andreasbuerkler/audio/hw/V1_0/fpga.brd

## EAGLE design hw/V1_0/fpga.brd (2018-10-08, an earlier design)

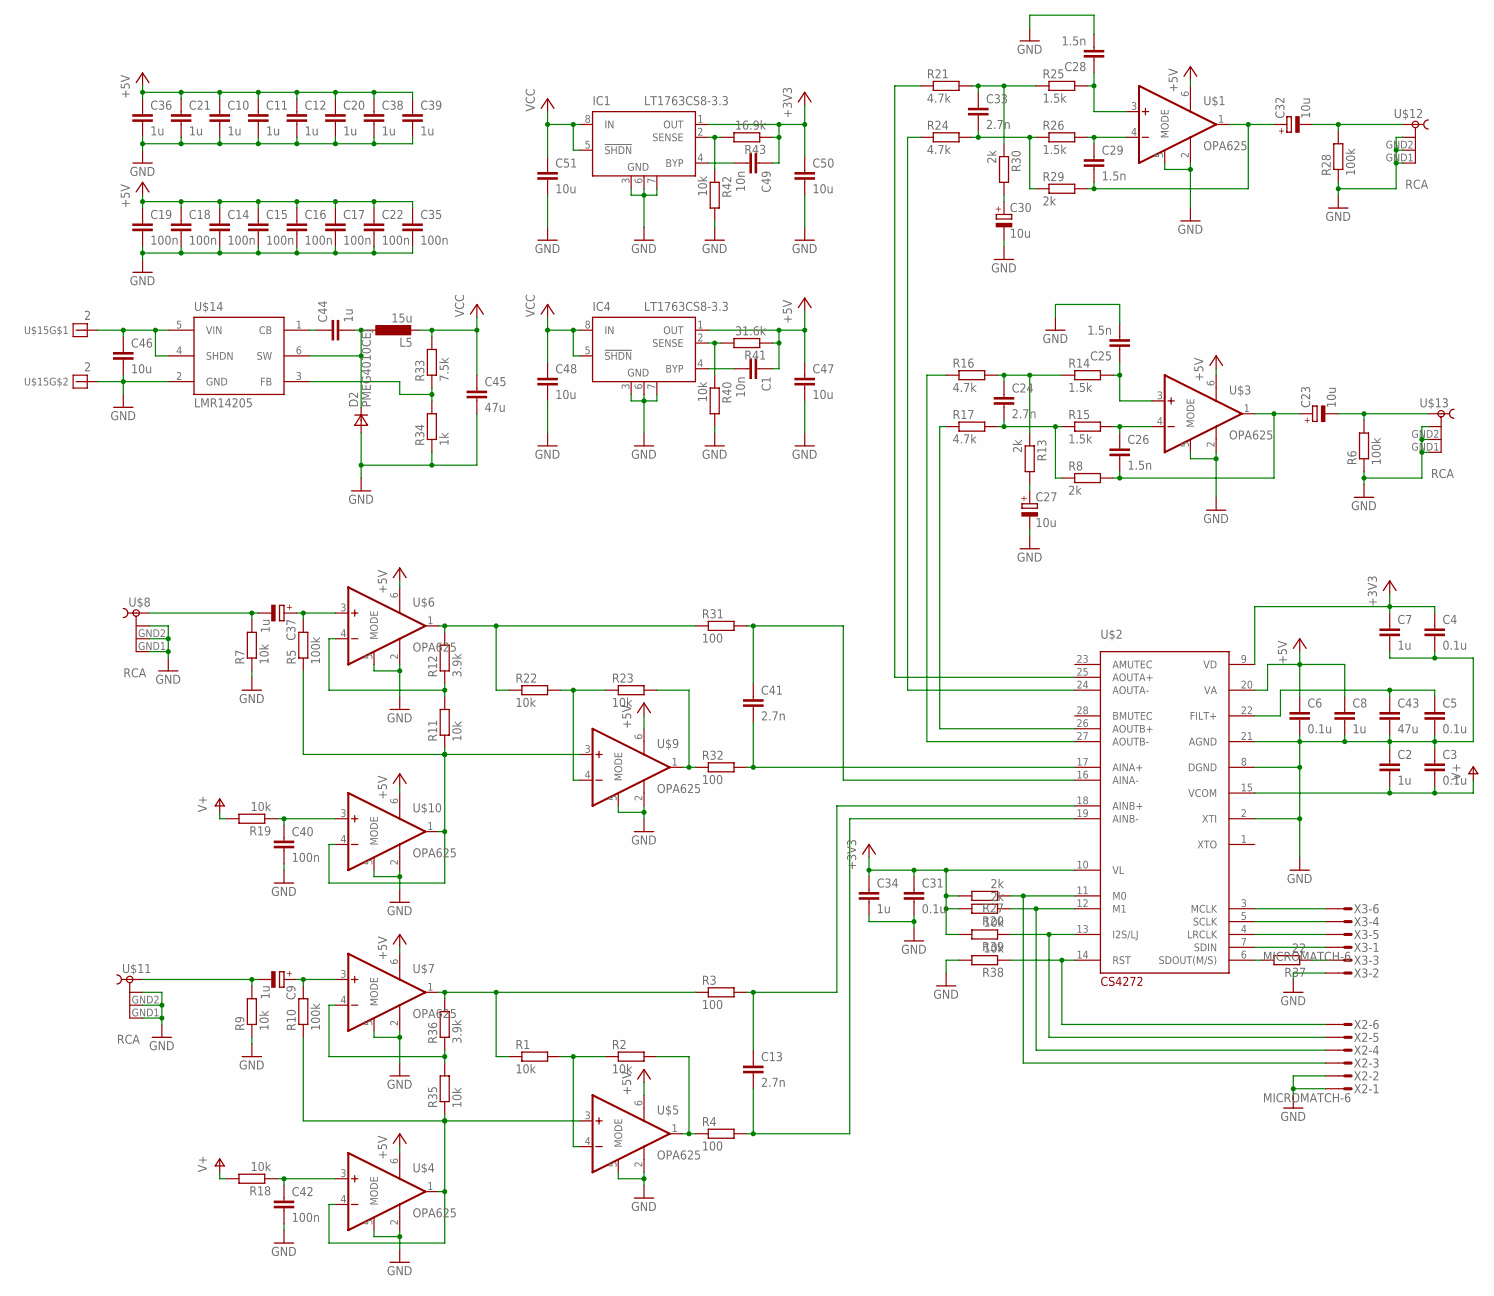
[picture p1: schematic fpga.sch]

Parts:
C1, C49: 10n; C0603K
C2, C7, C8, C10, C11, C12, C20, C21, C34, C36, C38, C39, C44: 1u; C0603K
C3, C4, C5, C6, C31: 0.1u; C0603K
C9, C37: 1u; 153CLV-0405
C13, C24, C33, C41: 2.7n; C0603K
C14, C15, C16, C17, C18, C19, C22, C35, C40, C42: 100n; C0603K
C23, C27, C30, C32: 10u; 153CLV-0405
C25, C26, C28, C29: 1.5n; C0603K
C43: 47u; C0805
C45: 47u; C1206
C46: 10u; C0805
C47, C48, C50, C51: 10u; C0603K
D2: PMEG4010CEJ; SOD323
IC1, IC4: LT1763CS8-3.3; SOIC8
L5: 15u; AAA
R1, R2, R7, R9, R11, R18, R19, R22, R23, R35, R38, R39, R40, R42: 10k; R0603
R3, R4, R31, R32: 100; R0603
R5, R6, R10, R28: 100k; R0603
R8, R13, R20, R27, R29, R30: 2k; R0603
R12, R36: 3.9k; R0603
R14, R15, R25, R26: 1.5k; R0603
R16, R17, R21, R24: 4.7k; R0603
R33: 7.5k; R0603
R34: 1k; R0603
R37: 22; R0603
R41: 31.6k; R0603
R43: 16.9k; R0603
U$1, U$3, U$4, U$5, U$6, U$7, U$9, U$10: OPA625; SOT23-6
U$2: CS4272; TSSOP28
U$8, U$11, U$12, U$13: RCA
U$14: LMR14205; TSOT23-6_DDC
U$15: 2
X2, X3: MICROMATCH-6

Connections:
+3V3: C4.1, C7.1, C31.1, C34.1, C49.1, C50.1, IC1.1 (OUT), R20.2, R27.2, R39.2, R43.1, U$2.9 (VD), U$2.10 (VL)
+5V: C1.1, C6.1, C8.1, C10.1, C11.1, C12.1, C14.1, C15.1, C16.1, C17.1, C18.1, C19.1, C20.1, C21.1, C22.1, C35.1, C36.1, C38.1, C39.1, C47.1, IC4.1 (OUT), R41.1, U$1.6 (V+), U$2.20 (VA), U$3.6 (V+), U$4.6 (V+), U$5.6 (V+), U$6.6 (V+), U$7.6 (V+), U$9.6 (V+), U$10.6 (V+)
GND: C2.1, C3.1, C4.2, C5.2, C6.2, C7.2, C8.2, C10.2, C11.2, C12.2, C14.2, C15.2, C16.2, C17.2, C18.2, C19.2, C20.2, C21.2, C22.2, C25.2, C27.-, C28.2, C30.-, C31.2, C34.2, C35.2, C36.2, C38.2, C39.2, C40.2, C42.2, C43.2, C45.2, C46.2, C47.2, C48.2, C50.2, C51.2, D2.2 (A), IC1.3 (GND), IC1.6 (GND), IC1.7 (GND), IC4.3 (GND), IC4.6 (GND), IC4.7 (GND), R6.1, R7.1, R9.1, R28.1, R34.1, R38.2, R40.2, R42.2, U$1.2 (V-), U$1.5 (MODE), U$2.2 (XTI), U$2.8 (DGND), U$2.21 (AGND), U$3.2 (V-), U$3.5 (MODE), U$4.2 (V-), U$4.5 (MODE), U$5.2 (V-), U$5.5 (MODE), U$6.2 (V-), U$6.5 (MODE), U$7.2 (V-), U$7.5 (MODE), U$8.GND1 (4), U$8.GND2 (3), U$8.GND3 (2), U$9.2 (V-), U$9.5 (MODE), U$10.2 (V-), U$10.5 (MODE), U$11.GND1 (4), U$11.GND2 (3), U$11.GND3 (2), U$12.GND1 (4), U$12.GND2 (3), U$12.GND3 (2), U$13.GND1 (4), U$13.GND2 (3), U$13.GND3 (2), U$14.2 (GND), U$15.P$2, X2.1, X2.2, X3.2
unnamed: R10.1, R35.1, U$4.1 (OUT), U$4.4 (-IN), U$5.3 (+IN)
unnamed: C9.+, R10.2, U$7.3 (+IN)
unnamed: R2.2, R4.1, U$5.1 (OUT)
unnamed: C5.1, C43.1, U$2.22 (FILT+)
unnamed: R1.2, R2.1, U$5.4 (-IN)
unnamed: C40.1, R19.1, U$10.3 (+IN)
unnamed: C24.1, R13.1, R14.1, R16.2
unnamed: C13.1, R3.2, U$2.18 (AINB+)
unnamed: C13.2, R4.2, U$2.19 (AINB-)
unnamed: R12.2, R22.1, R31.1, U$6.1 (OUT)
unnamed: C24.2, R8.1, R15.1, R17.2
unnamed: C37.-, R7.2, U$8.S1 (1)
unnamed: C9.-, R9.2, U$11.S1 (1)
unnamed: C25.1, R14.2, U$3.3 (+IN)
unnamed: C26.1, R15.2, U$3.4 (-IN)
unnamed: C23.+, C26.2, R8.2, U$3.1 (OUT)
unnamed: C23.-, R6.2, U$13.S1 (1)
unnamed: C27.+, R13.2
unnamed: C30.+, R30.2
unnamed: C42.1, R18.1, U$4.3 (+IN)
unnamed: IC1.2 (SENSE), R42.1, R43.2
unnamed: R17.1, U$2.26 (AOUTB+)
unnamed: R16.1, U$2.27 (AOUTB-)
unnamed: C49.2, IC1.4 (BYP)
unnamed: R24.1, U$2.24 (AOUTA-)
unnamed: R21.1, U$2.25 (AOUTA+)
unnamed: C33.1, R21.2, R25.1, R30.1
unnamed: R11.2, R12.1, U$6.4 (-IN)
unnamed: C33.2, R24.2, R26.1, R29.1
unnamed: C28.1, R25.2, U$1.3 (+IN)
unnamed: C29.1, R26.2, U$1.4 (-IN)
unnamed: C29.2, C32.+, R29.2, U$1.1 (OUT)
unnamed: R27.1, U$2.11 (M0), X2.3
unnamed: C41.2, R32.2, U$2.17 (AINA+)
unnamed: R1.1, R3.1, R36.2, U$7.1 (OUT)
unnamed: C32.-, R28.2, U$12.S1 (1)
unnamed: R20.1, U$2.12 (M1), X2.4
unnamed: C37.+, R5.2, U$6.3 (+IN)
unnamed: R35.2, R36.1, U$7.4 (-IN)
unnamed: C41.1, R31.2, U$2.16 (AINA-)
unnamed: R5.1, R11.1, U$9.3 (+IN), U$10.1 (OUT), U$10.4 (-IN)
unnamed: C44.1, U$14.1 (CB)
unnamed: R23.2, R32.1, U$9.1 (OUT)
unnamed: C44.2, D2.1 (C), L5.P$1 (1), U$14.6 (SW)
unnamed: R22.2, R23.1, U$9.4 (-IN)
unnamed: R33.1, R34.2, U$14.3 (FB)
unnamed: R38.1, U$2.14 (RST), X2.6
unnamed: R39.1, U$2.13 (I2S/LJ), X2.5
unnamed: U$2.3 (MCLK), X3.6
unnamed: U$2.5 (SCLK), X3.4
unnamed: U$2.4 (LRCLK), X3.5
unnamed: C46.1, U$14.4 (SHDN), U$14.5 (VIN), U$15.P$1
unnamed: U$2.7 (SDIN), X3.1
unnamed: R37.2, U$2.6 (SDOUT(M/S))
unnamed: R37.1, X3.3
unnamed: IC4.2 (SENSE), R40.1, R41.2
unnamed: C1.2, IC4.4 (BYP)
V+: C2.2, C3.2, R18.2, R19.2, U$2.15 (VCOM)
VCC: C45.1, C48.1, C51.1, IC1.5 (!SHDN), IC1.8 (IN), IC4.5 (!SHDN), IC4.8 (IN), L5.P$2 (2), R33.2

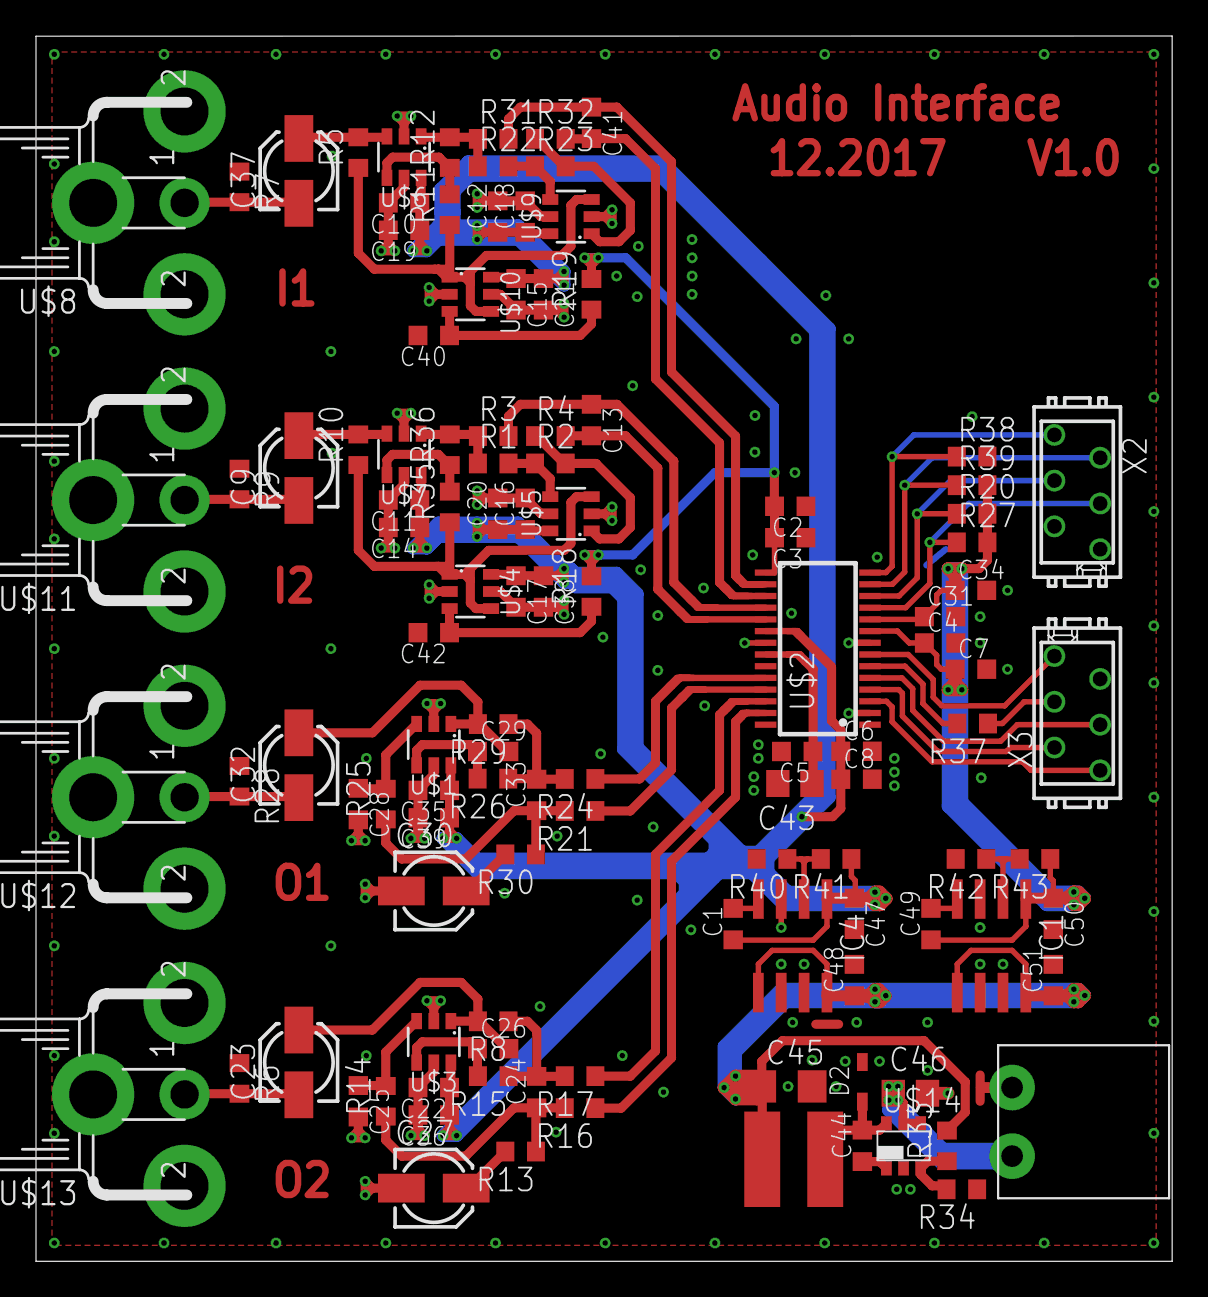
[picture p2: board hw/V1_0/fpga.brd from above]

Board: 2 copper layers, 63.1 x 68.1 mm, 115 parts (0 on the bottom side), 62 nets.
