andreasbuerkler/audio/hw/V2_0/fpga.brd

## EAGLE design hw/V2_0/fpga.brd (2018-10-08, an earlier design)

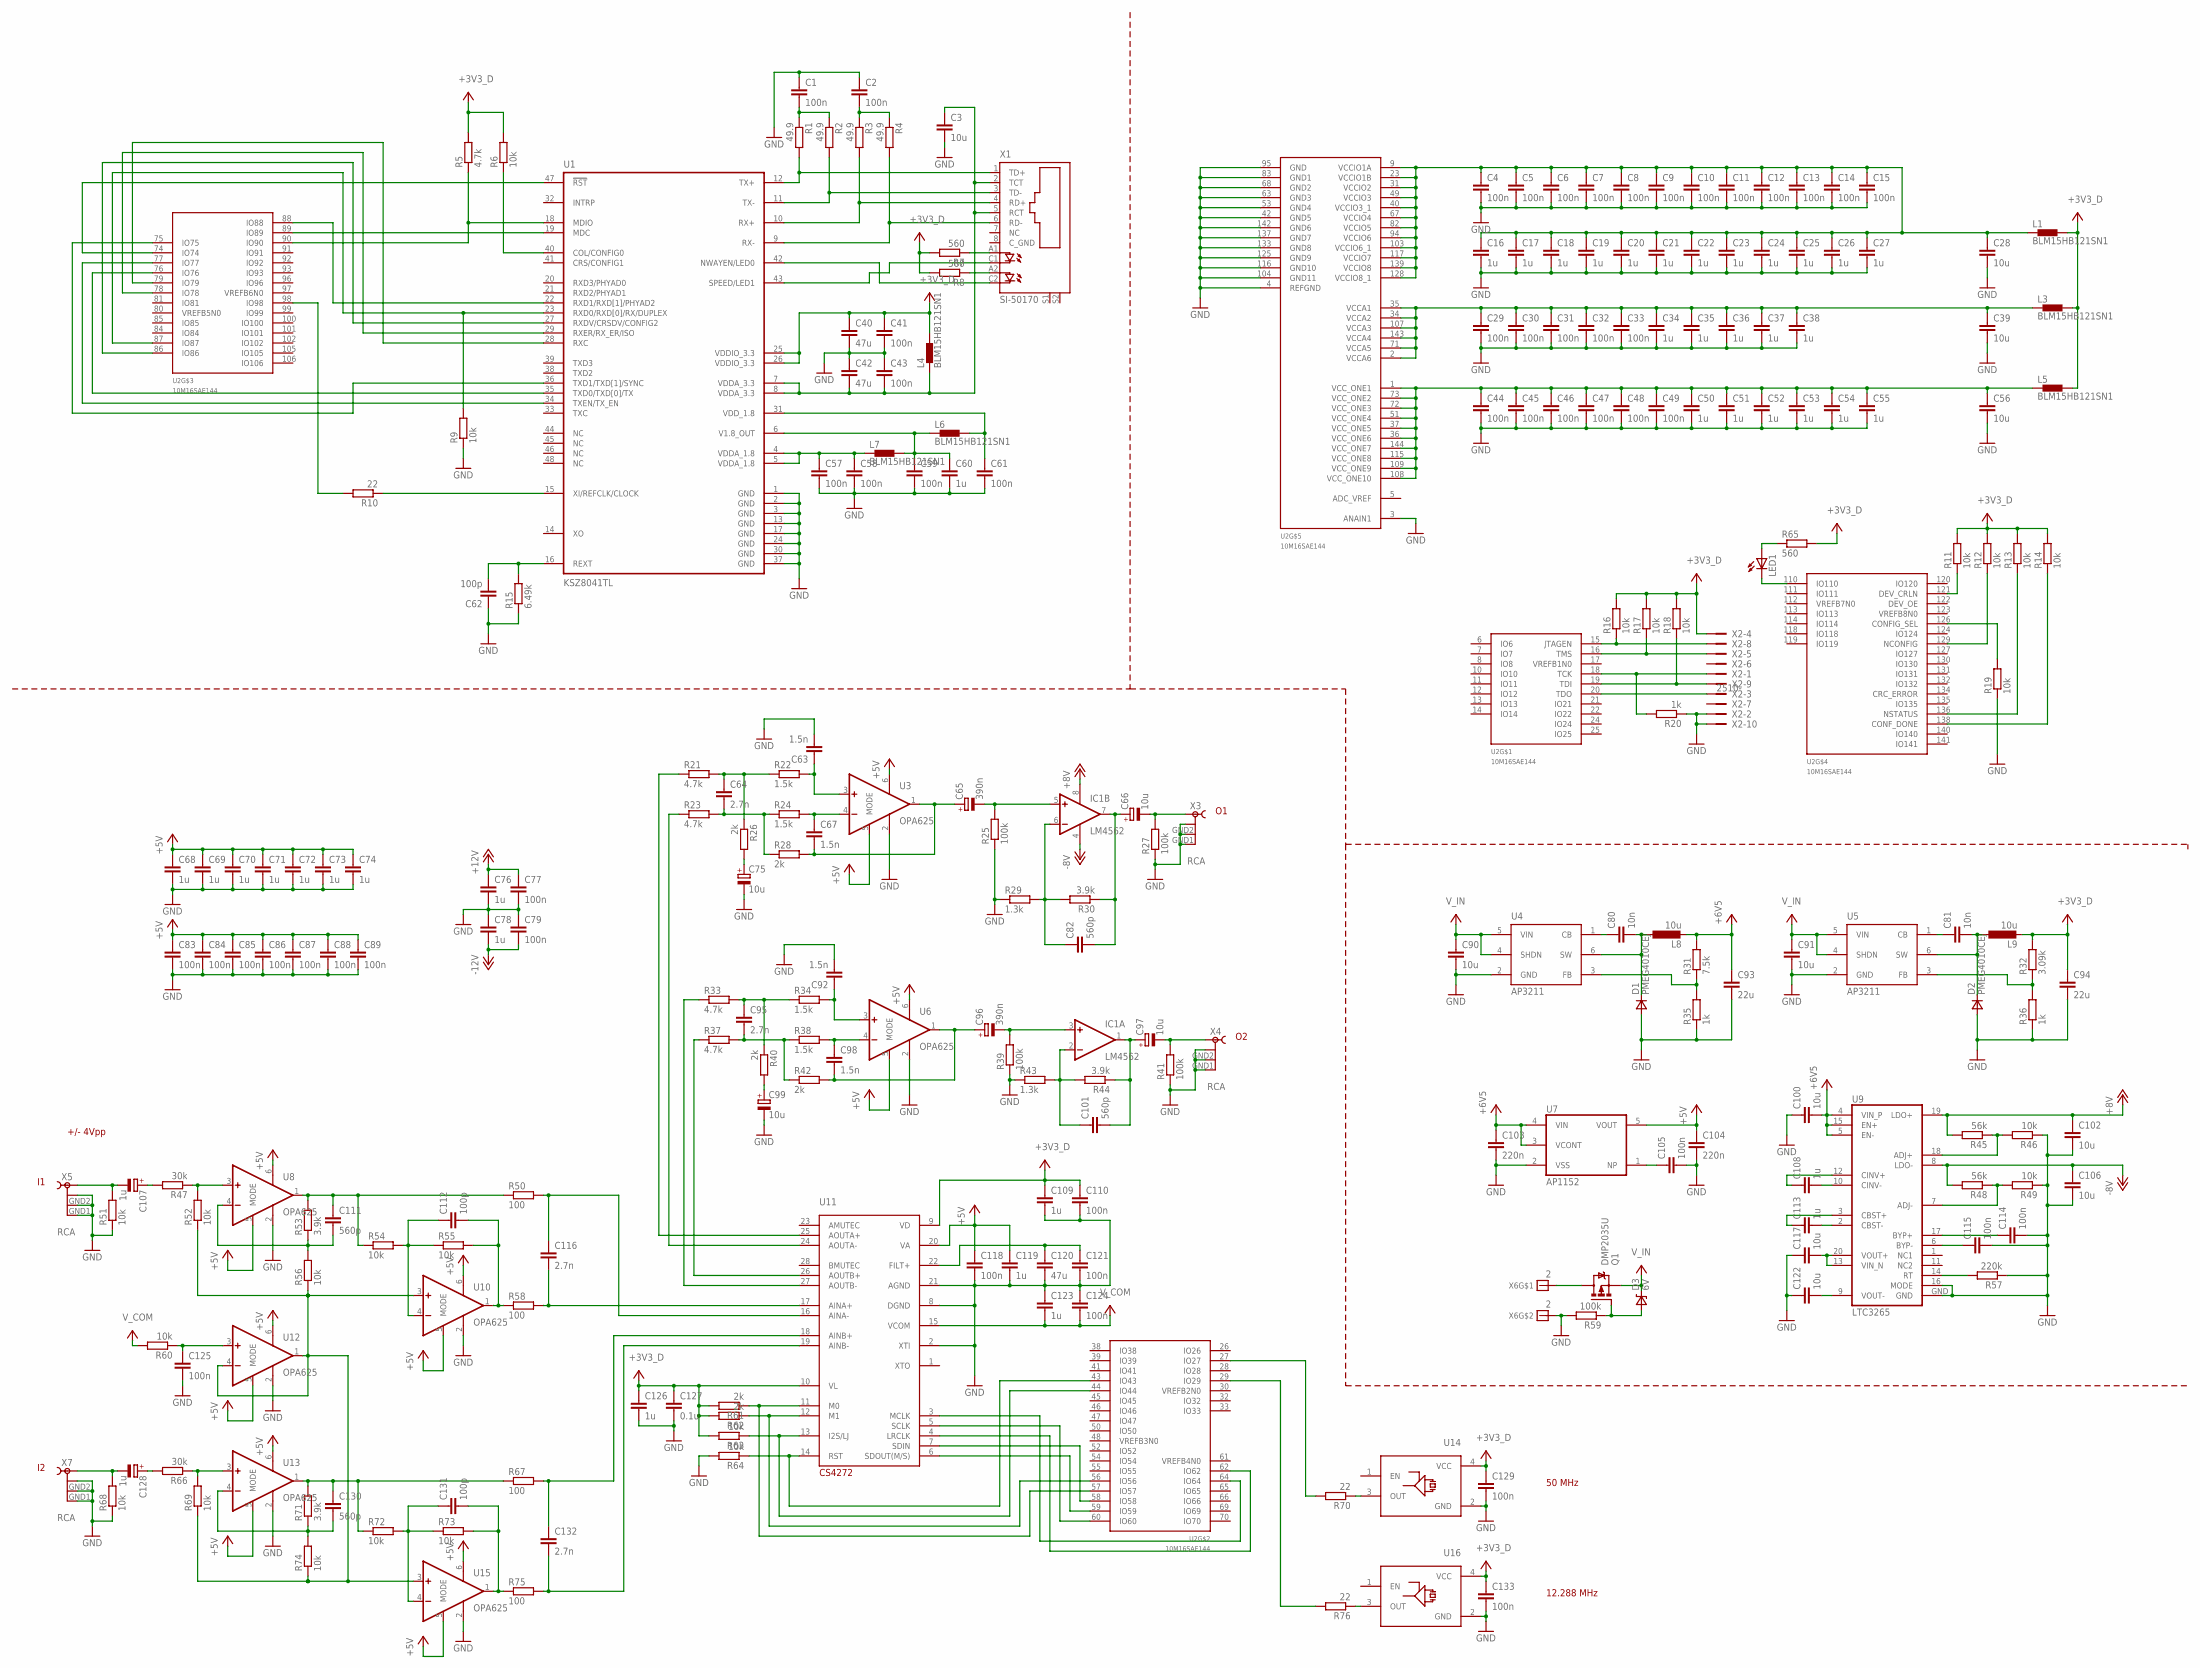
[picture p3: schematic fpga.sch]

Parts:
C1, C2, C4, C5, C6, C7, C8, C9, C10, C11, C12, C13, C14, C15, C29, C30, C31, C32, C33, C41, C43, C44, C45, C46, C47, C48, C49, C57, C58, C59, C61, C77, C79, C83, C84, C85, C86, C87, C88, C89, C105, C110, C114, C115, C118, C121, C124, C125, C129, C133: 100n; C0603K
C3, C90, C91: 10u; C0805
C16, C17, C18, C19, C20, C21, C22, C23, C24, C25, C26, C27, C34, C35, C36, C37, C38, C50, C51, C52, C53, C54, C55, C60, C68, C69, C70, C71, C72, C73, C74, C76, C78, C108, C109, C113, C119, C123, C126: 1u; C0603K
C28, C39, C56, C100, C102, C106, C117, C122: 10u; C0603K
C40, C42, C120: 47u; C0805
C62, C112, C131: 100p; C0603K
C63, C67, C92, C98: 1.5n; C0603K
C64, C95, C116, C132: 2.7n; C0603K
C65, C96: 390n; 153CLV-0405
C66, C75, C97, C99: 10u; 153CLV-0405
C80, C81: 10n; C0603K
C82, C101, C111, C130: 560p; C0603K
C93, C94: 22u; C1206
C103, C104: 220n; C0603K
C107, C128: 1u; 153CLV-0405
C127: 0.1u; C0603K
D1, D2: PMEG4010CEJ; SOD323
D3: 6V; SOD323
IC1: LM4562; SO08
L1, L3, L4, L5, L6, L7: BLM15HB121SN1; 0402
L8, L9: 10u; AAA
LED1: LEDCHIPLED_0603; CHIPLED_0603
Q1: DMP2035U; MICRO3
R1, R2, R3, R4: 49.9; R0603
R5, R21, R23, R33, R37: 4.7k; R0603
R6, R9, R11, R12, R13, R14, R16, R17, R18, R19, R46, R49, R51, R52, R54, R55, R56, R60, R63, R64, R68, R69, R72, R73, R74: 10k; R0603
R7, R8, R65: 560; R0603
R10, R70, R76: 22; R0603
R15: 6.49k; R0603
R20, R35, R36: 1k; R0603
R22, R24, R34, R38: 1.5k; R0603
R25, R27, R39, R41, R59: 100k; R0603
R26, R28, R40, R42, R61, R62: 2k; R0603
R29, R43: 1.3k; R0603
R30, R44, R53, R71: 3.9k; R0603
R31: 7.5k; R0603
R32: 3.09k; R0603
R45, R48: 56k; R0603
R47, R66: 30k; R0603
R50, R58, R67, R75: 100; R0603
R57: 220k; R0603
U1: KSZ8041TL; TQFP48
U2: 10M16SAE144; EQFP144
U3, U6, U8, U10, U12, U13, U15: OPA625; SOT23-6
U4, U5: AP3211; TSOT23-6_DDC
U7: AP1152; SOT89-5
U9: LTC3265; TSSOP20_GND
U11: CS4272; TSSOP28
U14: 49.152MHz; OSC
U16: 50MHz; OSC
X1: SI-50170
X2: 2510-; PAK100/2500-10
X3, X4, X5, X7: RCA
X6: 2

Connections:
+3V3_D: C40.1, C41.1, C94.1, C109.1, C110.1, C126.1, C127.1, C129.1, C133.1, L1.2, L3.2, L4.2, L5.2, L9.P$2 (2), R5.2, R6.2, R7.2, R8.2, R11.2, R12.2, R13.2, R14.2, R16.2, R17.2, R18.2, R32.2, R61.2, R62.2, R63.2, R65.2, U1.25 (VDDIO_3.3), U1.26 (VDDIO_3.3), U11.9 (VD), U11.10 (VL), U14.4 (VCC), U16.4 (VCC), X2.4
+5V: C68.1, C69.1, C70.1, C71.1, C72.1, C73.1, C74.1, C83.1, C84.1, C85.1, C86.1, C87.1, C88.1, C89.1, C104.1, C118.1, C119.1, U3.5 (MODE), U3.6 (V+), U6.5 (MODE), U6.6 (V+), U7.5 (VOUT), U8.5 (MODE), U8.6 (V+), U10.5 (MODE), U10.6 (V+), U11.20 (VA), U12.5 (MODE), U12.6 (V+), U13.5 (MODE), U13.6 (V+), U15.5 (MODE), U15.6 (V+)
+12V: C76.1, C77.1, C102.1, IC1.8 (V+), R45.2, U9.19 (LDO+)
-12V: C78.2, C79.2, C106.1, IC1.4 (V-), R48.2, U9.8 (LDO-)
GND: C1.1, C2.1, C3.2, C4.2, C5.2, C6.2, C7.2, C8.2, C9.2, C10.2, C11.2, C12.2, C13.2, C14.2, C15.2, C16.2, C17.2, C18.2, C19.2, C20.2, C21.2, C22.2, C23.2, C24.2, C25.2, C26.2, C27.2, C28.2, C29.2, C30.2, C31.2, C32.2, C33.2, C34.2, C35.2, C36.2, C37.2, C38.2, C39.2, C40.2, C41.2, C42.1, C43.1, C44.2, C45.2, C46.2, C47.2, C48.2, C49.2, C50.2, C51.2, C52.2, C53.2, C54.2, C55.2, C56.2, C57.2, C58.2, C59.2, C60.2, C61.2, C62.1, C63.2, C68.2, C69.2, C70.2, C71.2, C72.2, C73.2, C74.2, C75.-, C76.2, C77.2, C78.1, C79.1, C83.2, C84.2, C85.2, C86.2, C87.2, C88.2, C89.2, C90.2, C91.2, C92.2, C93.2, C94.2, C99.-, C100.1, C102.2, C103.2, C104.2, C105.2, C106.2, C109.2, C110.2, C114.2, C115.2, C117.1, C118.2, C119.2, C120.2, C121.2, C122.1, C123.1, C124.1, C125.2, C126.2, C127.2, C129.2, C133.2, D1.2 (A), D2.2 (A), R9.1, R15.1, R19.1, R20.1, R25.1, R27.1, R29.1, R35.1, R36.1, R39.1, R41.1, R43.1, R46.1, R49.1, R51.1, R57.1, R59.2, R64.2, R68.1, U1.1 (GND), U1.2 (GND), U1.3 (GND), U1.13 (GND), U1.17 (GND), U1.24 (GND), U1.30 (GND), U1.37 (GND), U2.3 (ANAIN1), U2.4 (REFGND), U2.42 (GND5), U2.53 (GND4), U2.63 (GND3), U2.68 (GND2), U2.83 (GND1), U2.95 (GND), U2.104 (GND11), U2.116 (GND10), U2.125 (GND9), U2.133 (GND8), U2.137 (GND7), U2.142 (GND6), U3.2 (V-), U4.2 (GND), U5.2 (GND), U6.2 (V-), U7.2 (VSS), U8.2 (V-), U9.16 (MODE), U9.GND, U10.2 (V-), U11.2 (XTI), U11.8 (DGND), U11.21 (AGND), U12.2 (V-), U13.2 (V-), U14.2 (GND), U15.2 (V-), U16.2 (GND), X2.2, X2.10, X3.GND1 (4), X3.GND2 (3), X3.GND3 (2), X4.GND1 (4), X4.GND2 (3), X4.GND3 (2), X5.GND1 (4), X5.GND2 (3), X5.GND3 (2), X6.P$2, X7.GND1 (4), X7.GND2 (3), X7.GND3 (2)
unnamed: C115.1, U9.6 (BYP-)
unnamed: R66.1, R69.2, U13.3 (+IN)
unnamed: C131.2, R73.2, R75.1, U15.1 (OUT)
unnamed: C120.1, C121.1, U11.22 (FILT+)
unnamed: C131.1, R72.2, R73.1, U15.4 (-IN)
unnamed: C125.1, R60.1, U12.3 (+IN)
unnamed: C95.1, R33.2, R34.1, R40.1
unnamed: C132.1, R67.2, U11.18 (AINB+)
unnamed: C132.2, R75.2, U11.19 (AINB-)
unnamed: C111.1, R50.1, R53.2, R54.1, U8.1 (OUT)
unnamed: C44.1, C45.1, C46.1, C47.1, C48.1, C49.1, C50.1, C51.1, C52.1, C53.1, C54.1, C55.1, C56.1, L5.1, U2.1 (VCC_ONE1), U2.36 (VCC_ONE6), U2.37 (VCC_ONE5), U2.51 (VCC_ONE4), U2.72 (VCC_ONE3), U2.73 (VCC_ONE2), U2.108 (VCC_ONE10), U2.109 (VCC_ONE9), U2.115 (VCC_ONE8), U2.144 (VCC_ONE7)
unnamed: C95.2, R37.2, R38.1, R42.1
unnamed: C107.-, R51.2, X5.S1 (1)
unnamed: C128.-, R68.2, X7.S1 (1)
unnamed: C92.1, R34.2, U6.3 (+IN)
unnamed: C98.1, R38.2, U6.4 (-IN)
unnamed: C96.+, C98.2, R42.2, U6.1 (OUT)
unnamed: C97.-, R41.2, X4.S1 (1)
unnamed: C99.+, R40.2
unnamed: C75.+, R26.2
unnamed: R14.1, U2.138 (CONF_DONE)
unnamed: R70.1, U14.3 (OUT)
unnamed: R13.1, U2.136 (NSTATUS)
unnamed: R37.1, U11.26 (AOUTB+)
unnamed: R33.1, U11.27 (AOUTB-)
unnamed: R12.1, U2.129 (NCONFIG)
unnamed: R23.1, U11.24 (AOUTA-)
unnamed: R21.1, U11.25 (AOUTA+)
unnamed: C64.1, R21.2, R22.1, R26.1
unnamed: C111.2, R53.1, R56.2, U8.4 (-IN)
unnamed: R16.1, U2.15 (JTAGEN), X2.8
unnamed: C64.2, R23.2, R24.1, R28.1
unnamed: C63.1, R22.2, U3.3 (+IN)
unnamed: C67.1, R24.2, U3.4 (-IN)
unnamed: C65.+, C67.2, R28.2, U3.1 (OUT)
unnamed: R61.1, U2.57 (IO57), U11.11 (M0)
unnamed: C116.2, R58.2, U11.17 (AINA+)
unnamed: C130.1, R67.1, R71.2, R72.1, U13.1 (OUT)
unnamed: C65.-, IC1.5 (+IN), R25.2
unnamed: R62.1, U2.56 (IO56), U11.12 (M1)
unnamed: R47.1, R52.2, U8.3 (+IN)
unnamed: C130.2, R71.1, R74.2, U13.4 (-IN)
unnamed: C116.1, R50.2, U11.16 (AINA-)
unnamed: R52.1, R56.1, R69.1, R74.1, U10.3 (+IN), U12.1 (OUT), U12.4 (-IN), U15.3 (+IN)
unnamed: C80.1, U4.1 (CB)
unnamed: C112.2, R55.2, R58.1, U10.1 (OUT)
unnamed: C80.2, D1.1 (C), L8.P$1 (1), U4.6 (SW)
unnamed: C112.1, R54.2, R55.1, U10.4 (-IN)
unnamed: C81.1, U5.1 (CB)
unnamed: R31.1, R35.2, U4.3 (FB)
unnamed: R64.1, U2.43 (IO43), U11.14 (RST)
unnamed: R63.1, U2.44 (IO44), U11.13 (I2S/LJ)
unnamed: U2.64 (IO64), U11.3 (MCLK)
unnamed: U2.60 (IO60), U11.5 (SCLK)
unnamed: U2.62 (IO62), U11.4 (LRCLK)
unnamed: R76.1, U16.3 (OUT)
unnamed: U2.58 (IO58), U11.7 (SDIN)
unnamed: U2.59 (IO59), U11.6 (SDOUT(M/S))
unnamed: U1.42 (NWAYEN/LED0), X1.C2 (C1)
unnamed: C81.2, D2.1 (C), L9.P$1 (1), U5.6 (SW)
unnamed: R70.2, U2.27 (IO27)
unnamed: R32.1, R36.2, U5.3 (FB)
unnamed: R20.2, U2.18 (TCK), X2.1
unnamed: R19.2, U2.126 (CONFIG_SEL)
unnamed: C29.1, C30.1, C31.1, C32.1, C33.1, C34.1, C35.1, C36.1, C37.1, C38.1, C39.1, L3.1, U2.2 (VCCA6), U2.34 (VCCA2), U2.35 (VCCA1), U2.71 (VCCA5), U2.107 (VCCA3), U2.143 (VCCA4)
unnamed: R17.1, U2.16 (TMS), X2.5
unnamed: R18.1, U2.19 (TDI), X2.9
unnamed: C4.1, C5.1, C6.1, C7.1, C8.1, C9.1, C10.1, C11.1, C12.1, C13.1, C14.1, C15.1, C16.1, C17.1, C18.1, C19.1, C20.1, C21.1, C22.1, C23.1, C24.1, C25.1, C26.1, C27.1, C28.1, L1.1, U2.9 (VCCIO1A), U2.23 (VCCIO1B), U2.31 (VCCIO2), U2.40 (VCCIO3_1), U2.49 (VCCIO3), U2.67 (VCCIO4), U2.82 (VCCIO5), U2.94 (VCCIO6), U2.103 (VCCIO6_1), U2.117 (VCCIO7), U2.128 (VCCIO8_1), U2.139 (VCCIO8)
unnamed: U2.20 (TDO), X2.3
unnamed: Q1.3 (D), X6.P$1
unnamed: U1.43 (SPEED/LED1), X1.C1 (C)
unnamed: C57.1, C58.1, L7.1, U1.4 (VDDA_1.8), U1.5 (VDDA_1.8)
unnamed: LED1.C, U2.110 (IO110)
unnamed: C59.1, C60.1, L6.1, L7.2, U1.6 (V1.8_OUT)
unnamed: R7.1, X1.A1 (A)
unnamed: C61.1, L6.2, U1.31 (VDD_1.8)
unnamed: R8.1, X1.A2 (A1)
unnamed: R2.2, U1.11 (TX-), X1.3 (TD-)
unnamed: R1.2, U1.12 (TX+), X1.1 (TD+)
unnamed: R3.2, U1.10 (RX+), X1.4 (RD+)
unnamed: R4.2, U1.9 (RX-), X1.6 (RD-)
unnamed: C1.2, R1.1, R2.1
unnamed: C2.2, R3.1, R4.1
unnamed: LED1.A, R65.1
unnamed: C3.1, C42.2, C43.2, L4.1, U1.7 (VDDA_3.3), U1.8 (VDDA_3.3), X1.2 (TCT), X1.5 (RCT)
unnamed: D3.2 (A), Q1.1 (G), R59.1
unnamed: R10.1, U1.15 (XI/REFCLK/CLOCK)
unnamed: U1.34 (TXEN/TX_EN), U2.77 (IO77)
unnamed: U1.35 (TXD0/TXD[0]/TX), U2.76 (IO76)
unnamed: U1.36 (TXD1/TXD[1]/SYNC), U2.75 (IO75)
unnamed: U1.22 (RXD1/RXD[1]/PHYAD2), U2.88 (IO88)
unnamed: R9.2, U1.23 (RXD0/RXD[0]/RX/DUPLEX), U2.87 (IO87)
unnamed: U1.27 (RXDV/CRSDV/CONFIG2), U2.86 (IO86)
unnamed: U1.29 (RXER/RX_ER/ISO), U2.78 (IO78)
unnamed: R10.2, U2.98 (IO98)
unnamed: R6.1, U1.40 (COL/CONFIG0)
unnamed: U1.19 (MDC), U2.89 (IO89)
unnamed: R5.1, U1.18 (MDIO), U2.90 (IO90)
unnamed: U1.28 (RXC), U2.79 (IO79)
unnamed: U1.47 (!RST), U2.74 (IO74)
unnamed: C62.2, R15.2, U1.16 (REXT)
unnamed: R76.2, U2.29 (IO29)
unnamed: C96.-, IC1.3 (+IN), R39.2
unnamed: C82.1, IC1.6 (-IN), R29.2, R30.2
unnamed: C66.+, C82.2, IC1.7 (OUT), R30.1
unnamed: C66.-, R27.2, X3.S1 (1)
unnamed: C101.1, IC1.2 (-IN), R43.2, R44.2
unnamed: C97.+, C101.2, IC1.1 (OUT), R44.1
unnamed: R45.1, R46.2, U9.18 (ADJ+)
unnamed: C113.2, U9.2 (CBST-)
unnamed: C113.1, U9.3 (CBST+)
unnamed: C108.2, U9.10 (CINV-)
unnamed: C108.1, U9.12 (CINV+)
unnamed: C105.1, U7.1 (NP)
unnamed: C122.2, U9.9 (VOUT-)
unnamed: C117.2, U9.13 (VIN_N), U9.20 (VOUT+)
unnamed: R57.2, U9.14 (RT)
unnamed: C107.+, R47.2
unnamed: C114.1, U9.17 (BYP+)
unnamed: R48.1, R49.2, U9.7 (ADJ-)
unnamed: C128.+, R66.2
unnamed: R11.1, U2.121 (DEV_CRLN)
VCC: C93.1, C100.2, C103.1, L8.P$2 (2), R31.2, U7.3 (VCONT), U7.4 (VIN), U9.4 (VIN_P), U9.5 (EN-), U9.15 (EN+)
V_COM: C123.2, C124.2, R60.2, U11.15 (VCOM)
V_IN: C90.1, C91.1, D3.1 (C), Q1.2 (S), U4.4 (SHDN), U4.5 (VIN), U5.4 (SHDN), U5.5 (VIN)

Notes on the sheet:
50 MHz
12.288 MHz
+/- 4Vpp

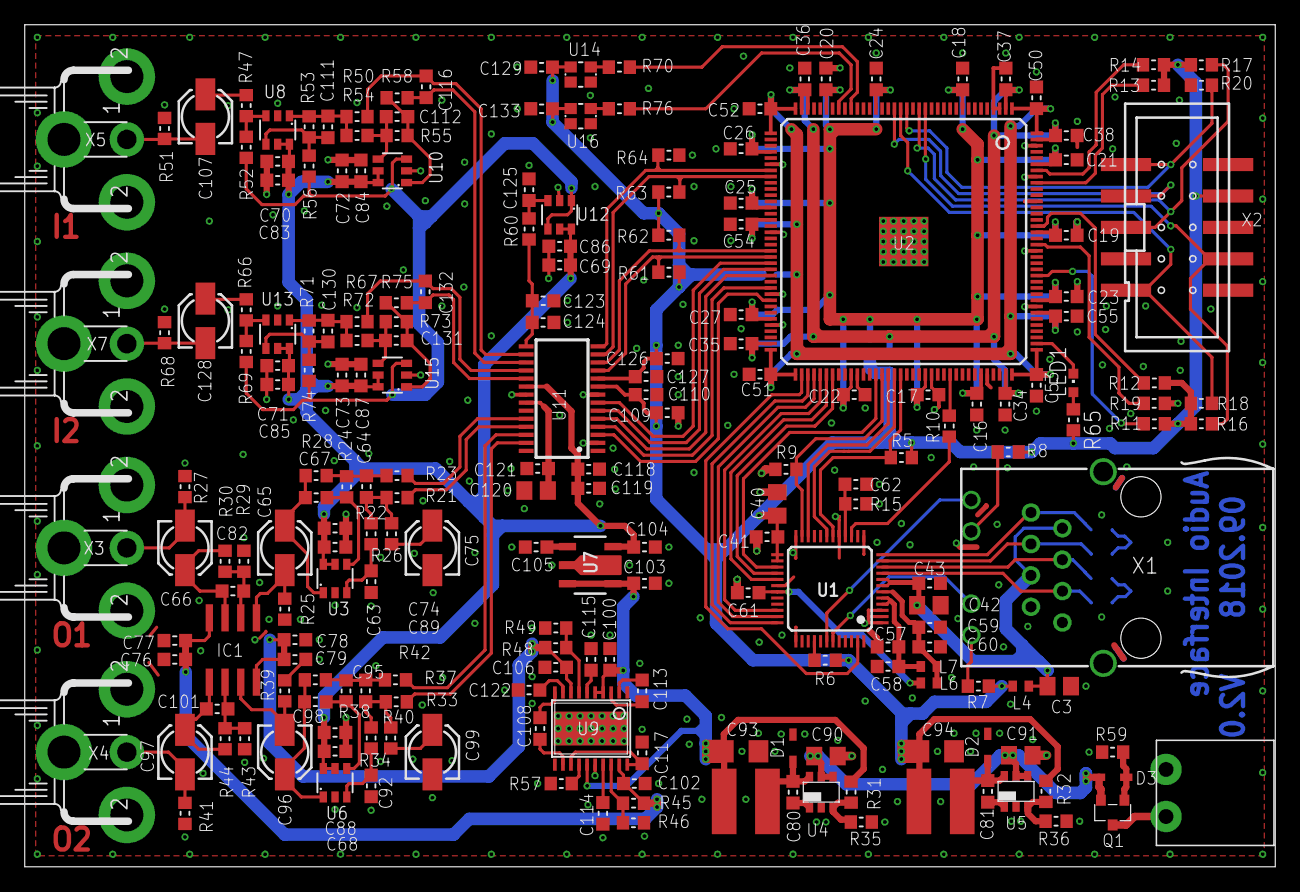
[picture p4: board hw/V2_0/fpga.brd from above]

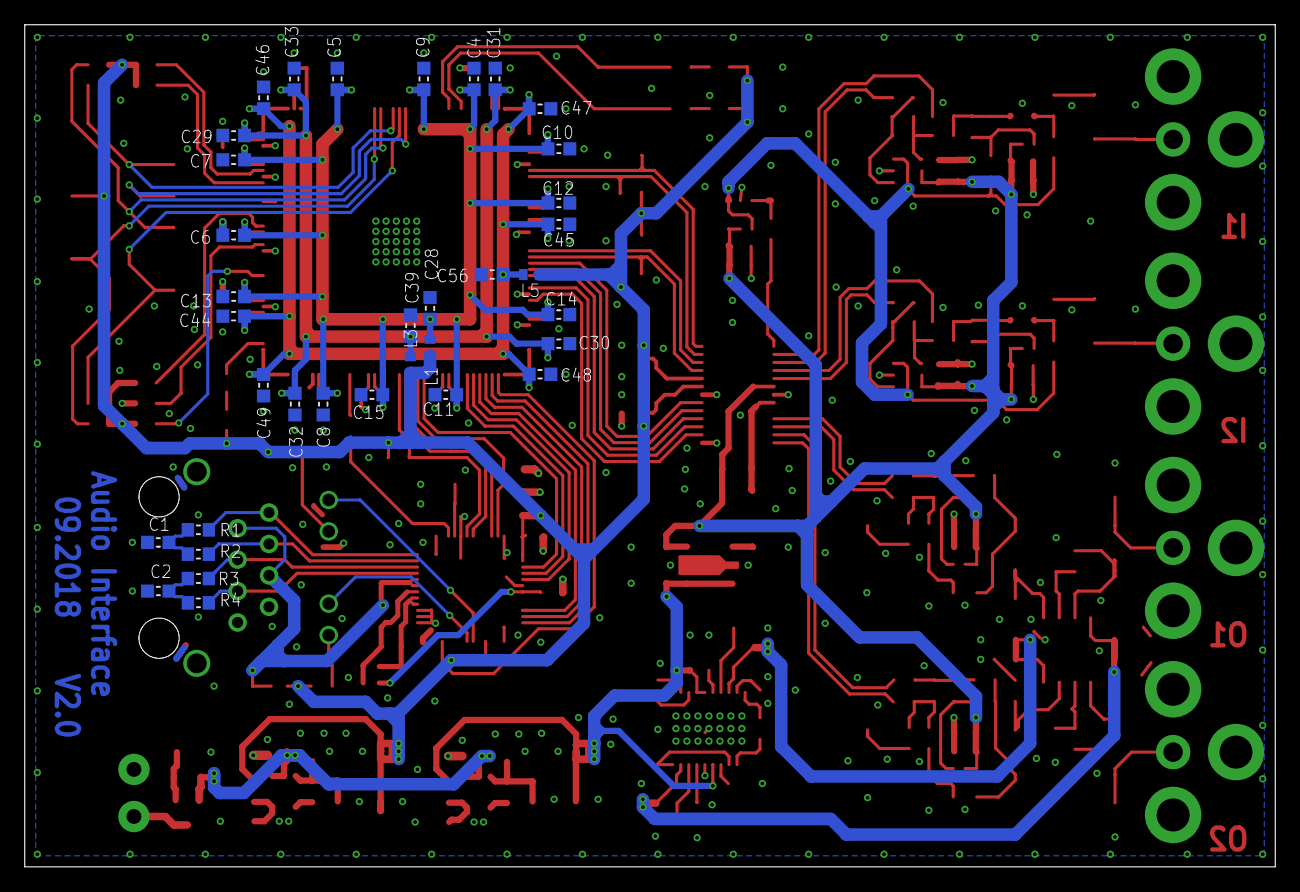
[picture p5: board hw/V2_0/fpga.brd from below]

Board: 2 copper layers, 101.1 x 68.1 mm, 246 parts (35 on the bottom side), 130 nets.
