andreasbuerkler/audio/fw/source/audio_top.vhd

--------------------------------------------------------------------------------
-- Author    : Andreas Buerkler
-- Date      : 07.10.2018
-- Filename  : audio_top.vhd
-- Changelog : 07.10.2018 - file created
--------------------------------------------------------------------------------

library ieee;
use ieee.std_logic_1164.all;
use ieee.numeric_std.all;

library work;
use work.fpga_pkg.all;

entity audio_top is
port (
    -- clock input
    clk50_000_i  : in    std_logic;
    clk12_288_i  : in    std_logic;

    --debug
    led_n_o      : out   std_logic;

    -- eth
    eth_rst_n_o  : out   std_logic;
    eth_refclk_o : out   std_logic;
    eth_rx_d0_i  : in    std_logic;
    eth_rx_d1_i  : in    std_logic;
    eth_rx_dv_i  : in    std_logic;
    eth_rx_er_i  : in    std_logic; -- not used
    eth_rx_clk_i : in    std_logic; -- not used
    eth_tx_d0_o  : out   std_logic;
    eth_tx_d1_o  : out   std_logic;
    eth_tx_en_o  : out   std_logic;
    eth_mdio_io  : inout std_logic;
    eth_mdc_o    : out   std_logic;

    -- audio codec
    i2s_rst_n_o  : out   std_logic;
    i2c_sda_io   : inout std_logic;
    i2c_scl_io   : inout std_logic;
    i2s_i        : in    std_logic;
    i2s_o        : out   std_logic;
    i2s_mclk_o   : out   std_logic;  -- 12.288 MHz
    i2s_bclk_o   : out   std_logic;  --  3.072 MHz
    i2s_lrclk_o  : out   std_logic); --     48 kHz
end entity audio_top;

architecture rtl of audio_top is

    component audio_pll is
    port (
        rst_i    : in  std_logic;
        clk_i    : in  std_logic;
        clkx4_o  : out std_logic;
        locked_o : out std_logic);
    end component audio_pll;

    component clock_converter is
    generic (
        data_width_g : natural;
        channels_g   : natural);
    port (
        in_clk_i  : in  std_logic;
        valid_i   : in  std_logic_vector(channels_g-1 downto 0);
        data_i    : in  std_logic_vector(data_width_g-1 downto 0);
        out_clk_i : in  std_logic;
        valid_o   : out std_logic_vector(channels_g-1 downto 0);
        data_o    : out std_logic_vector(data_width_g-1 downto 0));
    end component clock_converter;

    component i2c_config is
    generic (
        I2C_ADDRESS : std_logic_vector(7 downto 0);
        CONFIG      : std_logic_vector;
        FREQ_I      : positive;
        FREQ_O      : positive);
    port (
        clk_i   : in  std_logic;
        reset_i : in  std_logic;
        error_o : out std_logic;
        done_o  : out std_logic;
        scl_o   : out std_logic;
        sda_i   : in  std_logic;
        sda_o   : out std_logic);
    end component i2c_config;

    component i2s_inout is
    port (
        m_clk_i       : in  std_logic;
        b_clk_o       : out std_logic;
        lr_clk_o      : out std_logic;
        i2s_i         : in  std_logic;
        i2s_o         : out std_logic;
        right_valid_o : out std_logic;
        left_valid_o  : out std_logic;
        data_o        : out std_logic_vector(23 downto 0);
        right_valid_i : in  std_logic;
        left_valid_i  : in  std_logic;
        data_i        : in  std_logic_vector(23 downto 0));
    end component i2s_inout;

    component eth_mac is
    generic (
        fifo_size_exp_g : positive := 10);
    port (
        clk_i        : in  std_logic;
        reset_i      : in  std_logic;
        -- tx
        data_valid_i : in  std_logic;
        data_ready_o : out std_logic;
        last_i       : in  std_logic;
        data_i       : in  std_logic_vector(7 downto 0);
        -- rx
        data_valid_o : out std_logic;
        data_ready_i : in  std_logic;
        last_o       : out std_logic;
        data_o       : out std_logic_vector(7 downto 0);
        -- rmii
        rx_d_i       : in  std_logic_vector(1 downto 0);
        rx_dv_i      : in  std_logic;
        tx_d_o       : out std_logic_vector(1 downto 0);
        tx_en_o      : out std_logic);
    end component eth_mac;

    component eth_subsystem is
    generic (
        mac_address_g        : std_logic_vector(47 downto 0);
        ip_address_g         : std_logic_vector(31 downto 0);
        ctrl_port_g          : std_logic_vector(15 downto 0);
        ctrl_address_width_g : positive;
        ctrl_data_width_g    : positive);
    port (
        clk_i          : in  std_logic;
        reset_i        : in  std_logic;
        -- mac rx
        mac_valid_i    : in  std_logic;
        mac_ready_o    : out std_logic;
        mac_last_i     : in  std_logic;
        mac_data_i     : in  std_logic_vector(7 downto 0);
        -- mac tx
        mac_valid_o    : out std_logic;
        mac_ready_i    : in  std_logic;
        mac_last_o     : out std_logic;
        mac_data_o     : out std_logic_vector(7 downto 0);
        -- ctrl
        ctrl_address_o : out std_logic_vector(ctrl_address_width_g-1 downto 0);
        ctrl_data_o    : out std_logic_vector(ctrl_data_width_g-1 downto 0);
        ctrl_data_i    : in  std_logic_vector(ctrl_data_width_g-1 downto 0);
        ctrl_strobe_o  : out std_logic;
        ctrl_write_o   : out std_logic;
        ctrl_ack_i     : in  std_logic);
    end component eth_subsystem;

    component registerbank is
    generic (
        register_count_g : positive;
        register_init_g  : std_logic_array_32;
        register_mask_g  : std_logic_array_32;
        read_only_g      : std_logic_vector;
        data_width_g     : positive;
        address_width_g  : positive);
    port (
        clk_i          : in  std_logic;
        reset_i        : in  std_logic;
        -- register
        data_i         : in  std_logic_array_32(register_count_g-1 downto 0);
        data_strb_i    : in  std_logic_vector(register_count_g-1 downto 0);
        data_o         : out std_logic_array_32(register_count_g-1 downto 0);
        data_strb_o    : out std_logic_vector(register_count_g-1 downto 0);
        read_strb_o    : out std_logic_vector(register_count_g-1 downto 0);
        -- ctrl bus
        ctrl_address_i : in  std_logic_vector(address_width_g-1 downto 0);
        ctrl_data_i    : in  std_logic_vector(data_width_g-1 downto 0);
        ctrl_data_o    : out std_logic_vector(data_width_g-1 downto 0);
        ctrl_strobe_i  : in  std_logic;
        ctrl_write_i   : in  std_logic;
        ctrl_ack_o     : out std_logic);
    end component registerbank;

    component meter is
    generic (
        data_width_g : natural);
    port (
        audio_clk_i    : in  std_logic;
        left_valid_i   : in  std_logic;
        right_valid_i  : in  std_logic;
        data_i         : in  std_logic_vector(data_width_g-1 downto 0);
        register_clk_i : in  std_logic;
        data_read_l_i  : in  std_logic;
        data_read_r_i  : in  std_logic;
        level_l_o      : out std_logic_vector(7 downto 0);
        level_r_o      : out std_logic_vector(7 downto 0);
        level_strobe_o : out std_logic);
    end component meter;

    component crossfader is
    generic (
        data_width_g : natural);
    port (
        audio_clk_i       : in  std_logic;
        register_clk_i    : in  std_logic;
        -- audio in
        m_left_valid_i    : in  std_logic;
        m_right_valid_i   : in  std_logic;
        m_data_i          : in  std_logic_vector(data_width_g-1 downto 0);
        s_left_valid_i    : in  std_logic;
        s_right_valid_i   : in  std_logic;
        s_data_i          : in  std_logic_vector(data_width_g-1 downto 0);
        -- audio out
        left_valid_o      : out std_logic;
        right_valid_o     : out std_logic;
        data_o            : out std_logic_vector(data_width_g-1 downto 0);
        -- control
        m_level_valid_l_i : in  std_logic;
        m_level_valid_r_i : in  std_logic;
        m_level_l_i       : in  std_logic_vector(7 downto 0);
        m_level_r_i       : in  std_logic_vector(7 downto 0));
    end component crossfader;

    component convolution is
    generic (
        data_width_g : natural);
    port (
        audio_clk_i    : in  std_logic;
        register_clk_i : in  std_logic;
        -- audio in
        left_valid_i   : in  std_logic;
        right_valid_i  : in  std_logic;
        data_i         : in  std_logic_vector(data_width_g-1 downto 0);
        -- audio out
        left_valid_o   : out std_logic;
        right_valid_o  : out std_logic;
        data_o         : out std_logic_vector(data_width_g-1 downto 0);
        -- control
        address_i      : in  std_logic_vector(8 downto 0);
        coeff_i        : in  std_logic_vector(31 downto 0);
        wr_en_i        : in  std_logic);
    end component convolution;

    component sinus_gen is
    generic (
        data_width_g : natural);
    port (
        audio_clk_i    : in  std_logic;
        register_clk_i : in  std_logic;
        -- audio in
        request_i      : in  std_logic;
        -- audio out
        valid_o        : out std_logic;
        data_o         : out std_logic_vector(data_width_g-1 downto 0);
        -- control
        increment_i    : in  std_logic_vector(31 downto 0);
        change_i       : in  std_logic);
    end component sinus_gen;

    constant ctrl_address_width_c : positive := 16;
    constant ctrl_data_width_c    : positive := 32;

    constant mac_address_c   : std_logic_vector(47 downto 0) := x"3C8D20040506";
    constant ip_address_c    : std_logic_vector(31 downto 0) := x"C0A80164";
    constant ctrl_port_c     : std_logic_vector(15 downto 0) := x"1234";

    constant cs4272_addr_c   : std_logic_vector(7 downto 0) := x"11";
    constant cs4272_config_c : std_logic_vector := x"07_03" &
                                                   x"01_01" &
                                                   x"02_80" &
                                                   x"03_29" &
                                                   x"04_00" &
                                                   x"05_00" &
                                                   x"06_10" &
                                                   x"07_02";

    constant register_count_c                : positive := 16;
    constant register_address_version_c      : natural  := 0;
    constant register_address_in_meter_r_c   : natural  := 1;
    constant register_address_in_meter_l_c   : natural  := 2;
    constant register_address_in_fader_r_c   : natural  := 3;
    constant register_address_in_fader_l_c   : natural  := 4;
    constant register_address_out_meter_r_c  : natural  := 5;
    constant register_address_out_meter_l_c  : natural  := 6;
    constant register_address_conv_fader_r_c : natural  := 7;
    constant register_address_conv_fader_l_c : natural  := 8;

    constant register_init_c      : std_logic_array_32(register_count_c-1 downto 0) :=
                                   (register_address_version_c    => x"BEEF0123",
                                    others => x"00000000");
    constant register_read_only_c : std_logic_vector(register_count_c-1 downto 0) :=
                                   (register_address_version_c      => '1',
                                    register_address_in_meter_r_c   => '1',
                                    register_address_in_meter_l_c   => '1',
                                    register_address_in_fader_r_c   => '0',
                                    register_address_in_fader_l_c   => '0',
                                    register_address_out_meter_r_c  => '1',
                                    register_address_out_meter_l_c  => '1',
                                    register_address_conv_fader_r_c => '0',
                                    register_address_conv_fader_l_c => '0',
                                    others                          => '0');
    constant register_mask_c      : std_logic_array_32(register_count_c-1 downto 0) :=
                                   (register_address_version_c      => x"ffffffff",
                                    register_address_in_meter_r_c   => x"000000ff",
                                    register_address_in_meter_l_c   => x"000000ff",
                                    register_address_in_fader_r_c   => x"000000ff",
                                    register_address_in_fader_l_c   => x"000000ff",
                                    register_address_out_meter_r_c  => x"000000ff",
                                    register_address_out_meter_l_c  => x"000000ff",
                                    register_address_conv_fader_r_c => x"000000ff",
                                    register_address_conv_fader_l_c => x"000000ff",
                                    others                          => x"ffffffff");

    -- clocks
    signal clk49_152 : std_logic;

    -- reset
    signal reset_counter_r       : unsigned(23 downto 0) := (others => '0');
    signal codec_reset_n_r       : std_logic := '0';
    signal config_reset_r        : std_logic := '1';
    signal config_reset_cc_vec_r : std_logic_vector(2 downto 0) := (others => '1');

    -- status led
    signal blink_counter_r : unsigned(24 downto 0) := (others => '0');
    signal i2c_error       : std_logic;
    signal i2c_done        : std_logic;
    signal led_n_r         : std_logic := '1';

    -- codec
    signal i2c_scl         : std_logic;
    signal i2c_sda         : std_logic;
    signal i2s_bclk        : std_logic;
    signal i2s_lrclk       : std_logic;
    signal i2s_out         : std_logic;
    signal audio_l_valid   : std_logic;
    signal audio_r_valid   : std_logic;
    signal audio_data      : std_logic_vector(23 downto 0);

    -- eth
    signal tx_en : std_logic;
    signal tx_d  : std_logic_vector(1 downto 0);

    signal mac_rx_valid : std_logic;
    signal mac_rx_ready : std_logic;
    signal mac_rx_last  : std_logic;
    signal mac_rx_data  : std_logic_vector(7 downto 0);

    signal mac_tx_valid : std_logic;
    signal mac_tx_ready : std_logic;
    signal mac_tx_last  : std_logic;
    signal mac_tx_data  : std_logic_vector(7 downto 0);

    -- ctrl bus
    signal ctrl_address  : std_logic_vector(ctrl_address_width_c-1 downto 0);
    signal ctrl_data_in  : std_logic_vector(ctrl_data_width_c-1 downto 0);
    signal ctrl_data_out : std_logic_vector(ctrl_data_width_c-1 downto 0);
    signal ctrl_strobe   : std_logic;
    signal ctrl_write    : std_logic;
    signal ctrl_ack      : std_logic;

    -- registerbank
    signal register_read_data  : std_logic_array_32(register_count_c-1 downto 0) := (others => (others => '0'));
    signal register_read_strb  : std_logic_vector(register_count_c-1 downto 0) := (others => '0');
    signal register_was_read   : std_logic_vector(register_count_c-1 downto 0);
    signal register_write_data : std_logic_array_32(register_count_c-1 downto 0) := (others => (others => '0'));
    signal register_write_strb : std_logic_vector(register_count_c-1 downto 0);

    -- input meter
    signal in_meter_r_level : std_logic_vector(7 downto 0);
    signal in_meter_l_level : std_logic_vector(7 downto 0);
    signal in_meter_strobe  : std_logic;

    -- input fader
    signal fader_l_valid      : std_logic;
    signal fader_r_valid      : std_logic;
    signal fader_data         : std_logic_vector(23 downto 0);
    signal fast_fader_l_valid : std_logic;
    signal fast_fader_r_valid : std_logic;
    signal fast_fader_data    : std_logic_vector(23 downto 0);

    -- convolution
    signal conv_l_valid      : std_logic;
    signal conv_r_valid      : std_logic;
    signal conv_data         : std_logic_vector(23 downto 0);
    signal fast_conv_l_valid : std_logic;
    signal fast_conv_r_valid : std_logic;
    signal fast_conv_data    : std_logic_vector(23 downto 0);

    -- convolution bypass fader
    signal conv_fader_l_valid : std_logic;
    signal conv_fader_r_valid : std_logic;
    signal conv_fader_data    : std_logic_vector(23 downto 0);

    -- output meter
    signal out_meter_r_level : std_logic_vector(7 downto 0);
    signal out_meter_l_level : std_logic_vector(7 downto 0);
    signal out_meter_strobe  : std_logic;

begin

    i_pll : audio_pll
    port map (
        rst_i    => '0',
        clk_i    => clk12_288_i,
        clkx4_o  => clk49_152,
        locked_o => open);

    reset_proc : process (clk12_288_i)
    begin
        if (rising_edge(clk12_288_i)) then
            if (reset_counter_r(reset_counter_r'high) = '0') then
                reset_counter_r <= reset_counter_r + 1;
            end if;
            if (reset_counter_r(reset_counter_r'high-1) = '1') then
                codec_reset_n_r <= '1';
            end if;
            config_reset_cc_vec_r(0) <= not reset_counter_r(reset_counter_r'high);
        end if;
    end process reset_proc;

    cc_proc : process (clk50_000_i)
    begin
        if (rising_edge(clk50_000_i)) then
            config_reset_cc_vec_r(config_reset_cc_vec_r'high downto 1 ) <= config_reset_cc_vec_r(config_reset_cc_vec_r'high -1 downto 0);
            config_reset_r <= config_reset_cc_vec_r(config_reset_cc_vec_r'high);
        end if;
    end process cc_proc;

    led_proc : process (clk50_000_i)
    begin
        if (rising_edge(clk50_000_i)) then
            blink_counter_r <= blink_counter_r + 1;
            led_n_r <= i2c_done and (not i2c_error) and blink_counter_r(blink_counter_r'high);
        end if;
    end process led_proc;

    i_config : i2c_config
    generic map (
        I2C_ADDRESS => cs4272_addr_c,
        CONFIG      => cs4272_config_c,
        FREQ_I      => 50000000,
        FREQ_O      => 100000)
    port map (
        clk_i        => clk50_000_i,
        reset_i      => config_reset_r,
        error_o      => i2c_error,
        done_o       => i2c_done,
        scl_o        => i2c_scl,
        sda_i        => i2c_sda_io,
        sda_o        => i2c_sda);

    i_i2s : i2s_inout
    port map (
        m_clk_i       => clk12_288_i,
        b_clk_o       => i2s_bclk,
        lr_clk_o      => i2s_lrclk,
        i2s_i         => i2s_i,
        i2s_o         => i2s_out,
        right_valid_o => audio_r_valid,
        left_valid_o  => audio_l_valid,
        data_o        => audio_data,
        right_valid_i => conv_r_valid,
        left_valid_i  => conv_l_valid,
        data_i        => conv_data);

    i_input_meter : meter
    generic map (
        data_width_g => 24)
    port map (
        audio_clk_i    => clk12_288_i,
        left_valid_i   => audio_l_valid,
        right_valid_i  => audio_r_valid,
        data_i         => audio_data,
        register_clk_i => clk50_000_i,
        data_read_l_i  => register_was_read(register_address_in_meter_l_c),
        data_read_r_i  => register_was_read(register_address_in_meter_r_c),
        level_l_o      => in_meter_l_level,
        level_r_o      => in_meter_r_level,
        level_strobe_o => in_meter_strobe);

    i_input_fader : crossfader
    generic map (
        data_width_g => 24)
    port map (
        audio_clk_i       => clk12_288_i,
        register_clk_i    => clk50_000_i,
        -- audio in
        m_left_valid_i    => audio_l_valid,
        m_right_valid_i   => audio_r_valid,
        m_data_i          => audio_data,
        s_left_valid_i    => '0',
        s_right_valid_i   => '0',
        s_data_i          => x"000000",
        -- audio out
        left_valid_o      => fader_l_valid,
        right_valid_o     => fader_r_valid,
        data_o            => fader_data,
        -- control
        m_level_valid_l_i => register_write_strb(register_address_in_fader_l_c),
        m_level_valid_r_i => register_write_strb(register_address_in_fader_r_c),
        m_level_l_i       => register_write_data(register_address_in_fader_l_c)(7 downto 0),
        m_level_r_i       => register_write_data(register_address_in_fader_r_c)(7 downto 0));

    i_cc_12to49 : clock_converter
    generic map (
        data_width_g => 24,
        channels_g   => 2)
    port map (
        in_clk_i   => clk12_288_i,
        valid_i(0) => fader_l_valid,
        valid_i(1) => fader_r_valid,
        data_i     => fader_data,
        out_clk_i  => clk49_152,
        valid_o(0) => fast_fader_l_valid,
        valid_o(1) => fast_fader_r_valid,
        data_o     => fast_fader_data);

    i_conv : convolution
    generic map (
        data_width_g => 24)
    port map (
        audio_clk_i    => clk49_152,
        register_clk_i => clk50_000_i,
        -- audio in
        left_valid_i   => fast_fader_l_valid,
        right_valid_i  => fast_fader_r_valid,
        data_i         => fast_fader_data,
        -- audio out
        left_valid_o   => fast_conv_l_valid,
        right_valid_o  => fast_conv_r_valid,
        data_o         => fast_conv_data,
        -- control
        address_i      => "000000000",
        coeff_i        => x"00000000",
        wr_en_i        => '0');

    i_conv_bypass : crossfader
    generic map (
        data_width_g => 24)
    port map (
        audio_clk_i       => clk49_152,
        register_clk_i    => clk50_000_i,
        -- audio in
        m_left_valid_i    => fast_conv_l_valid,
        m_right_valid_i   => fast_conv_r_valid,
        m_data_i          => fast_conv_data,
        s_left_valid_i    => fast_fader_l_valid,
        s_right_valid_i   => fast_fader_r_valid,
        s_data_i          => fast_fader_data,
        -- audio out
        left_valid_o      => conv_fader_l_valid,
        right_valid_o     => conv_fader_r_valid,
        data_o            => conv_fader_data,
        -- control
        m_level_valid_l_i => register_write_strb(register_address_conv_fader_l_c),
        m_level_valid_r_i => register_write_strb(register_address_conv_fader_r_c),
        m_level_l_i       => register_write_data(register_address_conv_fader_l_c)(7 downto 0),
        m_level_r_i       => register_write_data(register_address_conv_fader_r_c)(7 downto 0));

    i_cc_49to12 : clock_converter
    generic map (
        data_width_g => 24,
        channels_g   => 2)
    port map (
        in_clk_i   => clk49_152,
        valid_i(0) => conv_fader_l_valid,
        valid_i(1) => conv_fader_r_valid,
        data_i     => conv_fader_data,
        out_clk_i  => clk12_288_i,
        valid_o(0) => conv_l_valid,
        valid_o(1) => conv_r_valid,
        data_o     => conv_data);

    i_sin : sinus_gen
    generic map (
        data_width_g => 24)
    port map (
        audio_clk_i    => clk12_288_i,
        register_clk_i => clk50_000_i,
        -- audio in
        request_i      => conv_fader_l_valid,
        -- audio out
        valid_o        => open,
        data_o         => open,
        -- control
        increment_i    => x"00000000",
        change_i       => '0');

    i_output_meter : meter
    generic map (
        data_width_g => 24)
    port map (
        audio_clk_i    => clk12_288_i,
        left_valid_i   => conv_l_valid,
        right_valid_i  => conv_r_valid,
        data_i         => conv_data,
        register_clk_i => clk50_000_i,
        data_read_l_i  => register_was_read(register_address_out_meter_l_c),
        data_read_r_i  => register_was_read(register_address_out_meter_r_c),
        level_l_o      => out_meter_l_level,
        level_r_o      => out_meter_r_level,
        level_strobe_o => out_meter_strobe);

    i_mac : eth_mac
    generic map (
        fifo_size_exp_g => 11)
    port map (
        clk_i        => clk50_000_i,
        reset_i      => '0',
        -- tx
        data_valid_i => mac_tx_valid,
        data_ready_o => mac_tx_ready,
        last_i       => mac_tx_last,
        data_i       => mac_tx_data,
        -- rx
        data_valid_o => mac_rx_valid,
        data_ready_i => mac_rx_ready,
        last_o       => mac_rx_last,
        data_o       => mac_rx_data,
        -- rmii
        rx_d_i(0)    => eth_rx_d0_i,
        rx_d_i(1)    => eth_rx_d1_i,
        rx_dv_i      => eth_rx_dv_i,
        tx_d_o       => tx_d,
        tx_en_o      => tx_en);

    i_eth : eth_subsystem
    generic map (
        mac_address_g        => mac_address_c,
        ip_address_g         => ip_address_c,
        ctrl_port_g          => ctrl_port_c,
        ctrl_address_width_g => ctrl_address_width_c,
        ctrl_data_width_g    => ctrl_data_width_c)
    port map (
        clk_i          => clk50_000_i,
        reset_i        => '0',
        -- mac rx
        mac_valid_i    => mac_rx_valid,
        mac_ready_o    => mac_rx_ready,
        mac_last_i     => mac_rx_last,
        mac_data_i     => mac_rx_data,
        -- mac tx
        mac_valid_o    => mac_tx_valid,
        mac_ready_i    => mac_tx_ready,
        mac_last_o     => mac_tx_last,
        mac_data_o     => mac_tx_data,
        -- ctrl
        ctrl_address_o => ctrl_address,
        ctrl_data_o    => ctrl_data_out,
        ctrl_data_i    => ctrl_data_in,
        ctrl_strobe_o  => ctrl_strobe,
        ctrl_write_o   => ctrl_write,
        ctrl_ack_i     => ctrl_ack);

    i_registerbank : registerbank
    generic map (
        register_count_g => register_count_c,
        register_init_g  => register_init_c,
        register_mask_g  => register_mask_c,
        read_only_g      => register_read_only_c,
        data_width_g     => ctrl_data_width_c,
        address_width_g  => ctrl_address_width_c-2)
    port map (
        clk_i          => clk50_000_i,
        reset_i        => '0',
        -- register
        data_i         => register_read_data,
        data_strb_i    => register_read_strb,
        data_o         => register_write_data,
        data_strb_o    => register_write_strb,
        read_strb_o    => register_was_read,
        -- ctrl bus
        ctrl_address_i => ctrl_address(ctrl_address_width_c-1 downto 2),
        ctrl_data_i    => ctrl_data_out,
        ctrl_data_o    => ctrl_data_in,
        ctrl_strobe_i  => ctrl_strobe,
        ctrl_write_i   => ctrl_write,
        ctrl_ack_o     => ctrl_ack);

    -- register bank read
    register_read_data(register_address_in_meter_r_c)(in_meter_r_level'range) <= in_meter_r_level;
    register_read_data(register_address_in_meter_l_c)(in_meter_l_level'range) <= in_meter_l_level;
    register_read_strb(register_address_in_meter_r_c) <= in_meter_strobe;
    register_read_strb(register_address_in_meter_l_c) <= in_meter_strobe;
    register_read_data(register_address_out_meter_r_c)(out_meter_r_level'range) <= out_meter_r_level;
    register_read_data(register_address_out_meter_l_c)(out_meter_l_level'range) <= out_meter_l_level;
    register_read_strb(register_address_out_meter_r_c) <= out_meter_strobe;
    register_read_strb(register_address_out_meter_l_c) <= out_meter_strobe;

    -- output signals
    led_n_o      <= led_n_r;

    eth_rst_n_o  <= '1';
    eth_refclk_o <= clk50_000_i;
    eth_tx_en_o  <= tx_en;
    eth_tx_d0_o  <= tx_d(0);
    eth_tx_d1_o  <= tx_d(1);
    eth_mdio_io  <= 'Z';
    eth_mdc_o    <= '0';

    i2s_rst_n_o  <= codec_reset_n_r;
    i2c_sda_io   <= '0' when (i2c_sda = '0') else 'Z';
    i2c_scl_io   <= '0' when (i2c_scl = '0') else 'Z';

    i2s_o        <= i2s_out;
    i2s_mclk_o   <= clk12_288_i;
    i2s_bclk_o   <= i2s_bclk;
    i2s_lrclk_o  <= i2s_lrclk;

end rtl;
