andreasbuerkler/audio/fw/source/step_response_pkg.vhd

--------------------------------------------------------------------------------
-- Author    : Andreas Buerkler
-- Date      : 24.02.2019
-- Filename  : step_response_pkg.vhd
-- Changelog : 24.02.2019 - file created
--------------------------------------------------------------------------------

library ieee;
use ieee.std_logic_1164.all;
use ieee.numeric_std.all;

library work;
use work.fpga_pkg.all;

package step_response_pkg is

    constant step_response_c : std_logic_array(511 downto 0, 23 downto 0) := (
        0   => x"060FCD", 
        1   => x"11FDA5", 
        2   => x"1A4F17", 
        3   => x"1D13E4", 
        4   => x"1C2DF2", 
        5   => x"13F046", 
        6   => x"073DD5", 
        7   => x"FD1982", 
        8   => x"F5CBB1", 
        9   => x"F2B04B", 
        10  => x"F65138", 
        11  => x"FCF2C3", 
        12  => x"01B24F", 
        13  => x"04FB2C", 
        14  => x"0732B9", 
        15  => x"06BE7F", 
        16  => x"044E82", 
        17  => x"02AB33", 
        18  => x"029E98", 
        19  => x"035DBD", 
        20  => x"04A7AA", 
        21  => x"05C645", 
        22  => x"054D8B", 
        23  => x"03D483", 
        24  => x"023402", 
        25  => x"00C34B", 
        26  => x"0064C7", 
        27  => x"00C867", 
        28  => x"01C1B1", 
        29  => x"02C792", 
        30  => x"0299EA", 
        31  => x"0100A9", 
        32  => x"003720", 
        33  => x"006186", 
        34  => x"FFDFFA", 
        35  => x"FF4D94", 
        36  => x"0001E4", 
        37  => x"0134F6", 
        38  => x"01EF01", 
        39  => x"02B713", 
        40  => x"036DAB", 
        41  => x"0397F9", 
        42  => x"02FD0B", 
        43  => x"01C0F1", 
        44  => x"009144", 
        45  => x"003664", 
        46  => x"FFF56D", 
        47  => x"FF6157", 
        48  => x"FF2DCA", 
        49  => x"FF0476", 
        50  => x"FECDBA", 
        51  => x"FEFC81", 
        52  => x"FF6390", 
        53  => x"00061F", 
        54  => x"00C9DF", 
        55  => x"0141B6", 
        56  => x"01777F", 
        57  => x"016E2B", 
        58  => x"010C5F", 
        59  => x"0070DC", 
        60  => x"001DF6", 
        61  => x"FFD807", 
        62  => x"FF7667", 
        63  => x"FF3338", 
        64  => x"FECA60", 
        65  => x"FE1CC1", 
        66  => x"FDB003", 
        67  => x"FDDCC1", 
        68  => x"FE9BB9", 
        69  => x"FF9B46", 
        70  => x"0068E5", 
        71  => x"00A1F7", 
        72  => x"0082CD", 
        73  => x"00445C", 
        74  => x"FFA400", 
        75  => x"FECDFC", 
        76  => x"FE0D32", 
        77  => x"FD82B9", 
        78  => x"FD7A2D", 
        79  => x"FDDC8A", 
        80  => x"FE9FA3", 
        81  => x"FF8159", 
        82  => x"000AA4", 
        83  => x"002124", 
        84  => x"FFE62D", 
        85  => x"FFA7A4", 
        86  => x"FF6E17", 
        87  => x"FF0CC9", 
        88  => x"FEA3CD", 
        89  => x"FE2699", 
        90  => x"FD567B", 
        91  => x"FC4C85", 
        92  => x"FB8569", 
        93  => x"FB2AF4", 
        94  => x"FB39CA", 
        95  => x"FBD06D", 
        96  => x"FCB891", 
        97  => x"FD88C2", 
        98  => x"FE6A10", 
        99  => x"FF5212", 
        100 => x"FFDFBC", 
        101 => x"FFF4BD", 
        102 => x"FFC55C", 
        103 => x"FF616D", 
        104 => x"FF18A8", 
        105 => x"FF2E0B", 
        106 => x"FF6FC0", 
        107 => x"FFAF90", 
        108 => x"FFDF97", 
        109 => x"FFABA3", 
        110 => x"FEEF4F", 
        111 => x"FDE4C8", 
        112 => x"FCE1F0", 
        113 => x"FC31D7", 
        114 => x"FBE4F3", 
        115 => x"FBF9B6", 
        116 => x"FC7F41", 
        117 => x"FD743A", 
        118 => x"FEA2EE", 
        119 => x"FFC02C", 
        120 => x"0078EE", 
        121 => x"0089C6", 
        122 => x"0023C8", 
        123 => x"FF813B", 
        124 => x"FEC5B4", 
        125 => x"FE2527", 
        126 => x"FDC297", 
        127 => x"FD9ACD", 
        128 => x"FDB0EE", 
        129 => x"FDD821", 
        130 => x"FDF9BF", 
        131 => x"FE07BE", 
        132 => x"FE0BCE", 
        133 => x"FDFBC3", 
        134 => x"FDE663", 
        135 => x"FDFD12", 
        136 => x"FE405E", 
        137 => x"FE951D", 
        138 => x"FEF993", 
        139 => x"FF4F8C", 
        140 => x"FF752F", 
        141 => x"FF50E0", 
        142 => x"FEF7FE", 
        143 => x"FE874B", 
        144 => x"FE26B8", 
        145 => x"FDF8A2", 
        146 => x"FDE6FA", 
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
        414 => x"00E906", 
        415 => x"00CF35", 
        416 => x"00B464", 
        417 => x"00A418", 
        418 => x"00A08F", 
        419 => x"00A3D8", 
        420 => x"00A934", 
        421 => x"00AEBF", 
        422 => x"00B76F", 
        423 => x"00BF43", 
        424 => x"00C85F", 
        425 => x"00D13A", 
        426 => x"00D6FE", 
        427 => x"00D746", 
        428 => x"00D863", 
        429 => x"00DCE8", 
        430 => x"00E92D", 
        431 => x"00F664", 
        432 => x"00FEFC", 
        433 => x"00FDD9", 
        434 => x"00F275", 
        435 => x"00D8A8", 
        436 => x"00B349", 
        437 => x"008ADF", 
        438 => x"006EB4", 
        439 => x"0062C3", 
        440 => x"006459", 
        441 => x"006ABF", 
        442 => x"007539", 
        443 => x"008588", 
        444 => x"009648", 
        445 => x"009AD1", 
        446 => x"009830", 
        447 => x"009755", 
        448 => x"009E92", 
        449 => x"00A948", 
        450 => x"00B815", 
        451 => x"00C8C6", 
        452 => x"00D2D5", 
        453 => x"00D0B2", 
        454 => x"00CD4A", 
        455 => x"00CCDD", 
        456 => x"00CBF8", 
        457 => x"00C3CA", 
        458 => x"00B3F4", 
        459 => x"0096D3",
        others => x"000000");

end step_response_pkg;
