andreasbuerkler/audio/fw/testbench/i2s_inout_tb.vhd

--------------------------------------------------------------------------------
-- Author    : Andreas Buerkler
-- Date      : 07.10.2018
-- Filename  : i2s_inout_tb.vhd
-- Changelog : 07.10.2018 - file created
--------------------------------------------------------------------------------

library ieee;
use ieee.std_logic_1164.all;
use ieee.numeric_std.all;
use ieee.math_real.all;

library work;
use work.fpga_pkg.all;

entity i2s_inout_tb is
end entity i2s_inout_tb;

architecture rtl of i2s_inout_tb is

    -- settings
    constant enable_fast_i2c_clock : boolean := true;

    -- low pass filter 1 kHz
    constant coeff_low_pass_a0_c : real :=  0.0039160766836994;
    constant coeff_low_pass_a1_c : real :=  0.0078321533673989;
    constant coeff_low_pass_a2_c : real :=  0.0039160766836994;
    constant coeff_low_pass_b1_c : real :=  1.8153179156742152;
    constant coeff_low_pass_b2_c : real := -0.8309822224090128;
    
    -- high pass filter 1 kHz
    constant coeff_high_pass_a0_c : real :=  0.9115859293184209;
    constant coeff_high_pass_a1_c : real := -1.8231718586368417;
    constant coeff_high_pass_a2_c : real :=  0.9115859293184209;
    constant coeff_high_pass_b1_c : real :=  1.8153396116625289;
    constant coeff_high_pass_b2_c : real := -0.8310041056111546;
    
    component audio is
    generic (
        I2C_ADDRESS : std_logic_vector(7 downto 0) := x"34";
        DATA_W      : natural := 24);
    port (
        -- i2c
        i2c_scl_i   : in  std_logic;
        i2c_sda_i   : in  std_logic;
        i2c_sda_o   : out std_logic;
        -- i2s
        i2s_i       : in  std_logic;
        i2s_o       : out std_logic;
        i2s_mclk_i  : in  std_logic;  -- 12.288 MHz
        i2s_lrclk_o : out std_logic); --     48 kHz
    end component audio;

    component i2s_inout is
    port (
        m_clk_i       : in  std_logic;
        b_clk_o       : out std_logic;
        lr_clk_o      : out std_logic;
        i2s_i         : in  std_logic;
        i2s_o         : out std_logic;
        right_valid_o : out std_logic;
        left_valid_o  : out std_logic;
        data_o        : out std_logic_vector(23 downto 0);
        right_valid_i : in  std_logic;
        left_valid_i  : in  std_logic;
        data_i        : in  std_logic_vector(23 downto 0));
    end component;

    procedure i2c_write_32 (
        constant device  : in  std_logic_vector(7 downto 0);
        constant address : in  std_logic_vector(7 downto 0);
        constant data    : in  std_logic_vector(31 downto 0);
        signal   i2c_clk : in  std_logic;
        signal   scl     : out std_logic;
        signal   sda     : out std_logic) is
        variable send_data_v : std_logic_vector(7 downto 0);
    begin
        -- start
        scl <= '1';
        sda <= '1';
        wait until rising_edge(i2c_clk);
        sda <= '0';
        wait until rising_edge(i2c_clk);
        scl <= '0';
        
        -- write slave address
        send_data_v := device(6 downto 0) & '0';
        for i in 0 to 7 loop
            wait until rising_edge(i2c_clk);
            sda <= send_data_v(send_data_v'high);
            send_data_v := send_data_v(send_data_v'high-1 downto 0) & '0';
            wait until rising_edge(i2c_clk);
            scl <= '1';
            wait until rising_edge(i2c_clk);
            wait until rising_edge(i2c_clk);
            scl <= '0';
        end loop;
        
        -- ack
        wait until rising_edge(i2c_clk);
        sda <= '1';
        wait until rising_edge(i2c_clk);
        scl <= '1';
        wait until rising_edge(i2c_clk);
        wait until rising_edge(i2c_clk);
        scl <= '0';
            
        -- write register address
        send_data_v := address;
        for i in 0 to 7 loop
            wait until rising_edge(i2c_clk);
            sda <= send_data_v(send_data_v'high);
            send_data_v := send_data_v(send_data_v'high-1 downto 0) & '0';
            wait until rising_edge(i2c_clk);
            scl <= '1';
            wait until rising_edge(i2c_clk);
            wait until rising_edge(i2c_clk);
            scl <= '0';
        end loop;
        
        -- ack
        wait until rising_edge(i2c_clk);
        sda <= '1';
        wait until rising_edge(i2c_clk);
        scl <= '1';
        wait until rising_edge(i2c_clk);
        wait until rising_edge(i2c_clk);
        scl <= '0';
        
        -- write data 1
        send_data_v := data(7 downto 0);
        for i in 0 to 7 loop
            wait until rising_edge(i2c_clk);
            sda <= send_data_v(send_data_v'high);
            send_data_v := send_data_v(send_data_v'high-1 downto 0) & '0';
            wait until rising_edge(i2c_clk);
            scl <= '1';
            wait until rising_edge(i2c_clk);
            wait until rising_edge(i2c_clk);
            scl <= '0';
        end loop;
        
        -- ack
        wait until rising_edge(i2c_clk);
        sda <= '1';
        wait until rising_edge(i2c_clk);
        scl <= '1';
        wait until rising_edge(i2c_clk);
        wait until rising_edge(i2c_clk);
        scl <= '0';
        
        -- write data 2
        send_data_v := data(15 downto 8);
        for i in 0 to 7 loop
            wait until rising_edge(i2c_clk);
            sda <= send_data_v(send_data_v'high);
            send_data_v := send_data_v(send_data_v'high-1 downto 0) & '0';
            wait until rising_edge(i2c_clk);
            scl <= '1';
            wait until rising_edge(i2c_clk);
            wait until rising_edge(i2c_clk);
            scl <= '0';
        end loop;
        
        -- ack
        wait until rising_edge(i2c_clk);
        sda <= '1';
        wait until rising_edge(i2c_clk);
        scl <= '1';
        wait until rising_edge(i2c_clk);
        wait until rising_edge(i2c_clk);
        scl <= '0';
        
        -- write data 3
        send_data_v := data(23 downto 16);
        for i in 0 to 7 loop
            wait until rising_edge(i2c_clk);
            sda <= send_data_v(send_data_v'high);
            send_data_v := send_data_v(send_data_v'high-1 downto 0) & '0';
            wait until rising_edge(i2c_clk);
            scl <= '1';
            wait until rising_edge(i2c_clk);
            wait until rising_edge(i2c_clk);
            scl <= '0';
        end loop;
        
        -- ack
        wait until rising_edge(i2c_clk);
        sda <= '1';
        wait until rising_edge(i2c_clk);
        scl <= '1';
        wait until rising_edge(i2c_clk);
        wait until rising_edge(i2c_clk);
        scl <= '0';
        
        -- write data 4
        send_data_v := data(31 downto 24);
        for i in 0 to 7 loop
            wait until rising_edge(i2c_clk);
            sda <= send_data_v(send_data_v'high);
            send_data_v := send_data_v(send_data_v'high-1 downto 0) & '0';
            wait until rising_edge(i2c_clk);
            scl <= '1';
            wait until rising_edge(i2c_clk);
            wait until rising_edge(i2c_clk);
            scl <= '0';
        end loop;
        
        -- ack
        wait until rising_edge(i2c_clk);
        sda <= '1';
        wait until rising_edge(i2c_clk);
        scl <= '1';
        wait until rising_edge(i2c_clk);
        wait until rising_edge(i2c_clk);
        scl <= '0';
        
        -- stop
        wait until rising_edge(i2c_clk);
        sda <= '0';
        wait until rising_edge(i2c_clk);
        scl <= '1';
        wait until rising_edge(i2c_clk);
        sda <= '1';
        wait until rising_edge(i2c_clk);
        wait until rising_edge(i2c_clk);
        wait until rising_edge(i2c_clk);
        wait until rising_edge(i2c_clk);

    end i2c_write_32;

    procedure i2c_read_32 (
        constant device  : in  std_logic_vector(7 downto 0);
        constant address : in  std_logic_vector(7 downto 0);
        signal   data    : out std_logic_vector(31 downto 0);
        signal   i2c_clk : in  std_logic;
        signal   scl     : out std_logic;
        signal   sda_in  : in  std_logic;
        signal   sda_out : out std_logic) is
        variable send_data_v : std_logic_vector(7 downto 0);
    begin
         -- start
        scl <= '1';
        sda_out <= '1';
        wait until rising_edge(i2c_clk);
        sda_out <= '0';
        wait until rising_edge(i2c_clk);
        scl <= '0';
        
        -- write slave address
        send_data_v := device(6 downto 0) & '0';
        for i in 0 to 7 loop
            wait until rising_edge(i2c_clk);
            sda_out <= send_data_v(send_data_v'high);
            send_data_v := send_data_v(send_data_v'high-1 downto 0) & '0';
            wait until rising_edge(i2c_clk);
            scl <= '1';
            wait until rising_edge(i2c_clk);
            wait until rising_edge(i2c_clk);
            scl <= '0';
        end loop;
        
        -- ack
        wait until rising_edge(i2c_clk);
        sda_out <= '1';
        wait until rising_edge(i2c_clk);
        scl <= '1';
        wait until rising_edge(i2c_clk);
        wait until rising_edge(i2c_clk);
        scl <= '0';
            
        -- write register address
        send_data_v := address;
        for i in 0 to 7 loop
            wait until rising_edge(i2c_clk);
            sda_out <= send_data_v(send_data_v'high);
            send_data_v := send_data_v(send_data_v'high-1 downto 0) & '0';
            wait until rising_edge(i2c_clk);
            scl <= '1';
            wait until rising_edge(i2c_clk);
            wait until rising_edge(i2c_clk);
            scl <= '0';
        end loop;
        
        -- ack
        wait until rising_edge(i2c_clk);
        sda_out <= '1';
        wait until rising_edge(i2c_clk);
        scl <= '1';
        wait until rising_edge(i2c_clk);
        wait until rising_edge(i2c_clk);
        scl <= '0';

        -- repeated start
        wait until rising_edge(i2c_clk);
        sda_out <= '1';
        wait until rising_edge(i2c_clk);
        scl <= '1';
        wait until rising_edge(i2c_clk);
        sda_out <= '0';
        wait until rising_edge(i2c_clk);
        scl <= '0';

        -- write slave address
        send_data_v := device(6 downto 0) & '1';
        for i in 0 to 7 loop
            wait until rising_edge(i2c_clk);
            sda_out <= send_data_V(send_data_v'high);
            send_data_v := send_data_v(send_data_v'high-1 downto 0) & '0';
            wait until rising_edge(i2c_clk);
            scl <= '1';
            wait until rising_edge(i2c_clk);
            wait until rising_edge(i2c_clk);
            scl <= '0';
        end loop;
        
        -- ack
        wait until rising_edge(i2c_clk);
        sda_out <= '1';
        wait until rising_edge(i2c_clk);
        scl <= '1';
        wait until rising_edge(i2c_clk);
        wait until rising_edge(i2c_clk);
        scl <= '0';
        
        -- read data 1
        send_data_v := x"FF";
        for i in 0 to 7 loop
            wait until rising_edge(i2c_clk);
            wait until rising_edge(i2c_clk);
            scl <= '1';
            wait until rising_edge(i2c_clk);
            send_data_v := send_data_v(send_data_v'high-1 downto 0) & sda_in;
            wait until rising_edge(i2c_clk);
            scl <= '0';
        end loop;
        
        data(7 downto 0) <= send_data_v;
        
        -- ack
        wait until rising_edge(i2c_clk);
        sda_out <= '0';
        wait until rising_edge(i2c_clk);
        scl <= '1';
        wait until rising_edge(i2c_clk);
        wait until rising_edge(i2c_clk);
        scl <= '0';
        
        -- read data 2
        send_data_v := x"FF";
        for i in 0 to 7 loop
            wait until rising_edge(i2c_clk);
            sda_out <= '1';
            wait until rising_edge(i2c_clk);
            scl <= '1';
            wait until rising_edge(i2c_clk);
            send_data_v := send_data_v(send_data_v'high-1 downto 0) & sda_in;
            wait until rising_edge(i2c_clk);
            scl <= '0';
        end loop;
        
        data(15 downto 8) <= send_data_v;
        
        -- ack
        wait until rising_edge(i2c_clk);
        sda_out <= '0';
        wait until rising_edge(i2c_clk);
        scl <= '1';
        wait until rising_edge(i2c_clk);
        wait until rising_edge(i2c_clk);
        scl <= '0';
        
        -- read data 3
        send_data_v := x"FF";
        for i in 0 to 7 loop
            wait until rising_edge(i2c_clk);
            sda_out <= '1';
            wait until rising_edge(i2c_clk);
            scl <= '1';
            wait until rising_edge(i2c_clk);
            send_data_v := send_data_v(send_data_v'high-1 downto 0) & sda_in;
            wait until rising_edge(i2c_clk);
            scl <= '0';
        end loop;
        
        data(23 downto 16) <= send_data_v;
        
        -- ack
        wait until rising_edge(i2c_clk);
        sda_out <= '0';
        wait until rising_edge(i2c_clk);
        scl <= '1';
        wait until rising_edge(i2c_clk);
        wait until rising_edge(i2c_clk);
        scl <= '0';
        
        -- read data 4
        send_data_v := x"FF";
        for i in 0 to 7 loop
            wait until rising_edge(i2c_clk);
            sda_out <= '1';
            wait until rising_edge(i2c_clk);
            scl <= '1';
            wait until rising_edge(i2c_clk);
            send_data_v := send_data_v(send_data_v'high-1 downto 0) & sda_in;
            wait until rising_edge(i2c_clk);
            scl <= '0';
        end loop;
        
        data(31 downto 24) <= send_data_v;
        
        -- nack
        wait until rising_edge(i2c_clk);
        sda_out <= '1';
        wait until rising_edge(i2c_clk);
        scl <= '1';
        wait until rising_edge(i2c_clk);
        wait until rising_edge(i2c_clk);
        scl <= '0';

        -- stop
        wait until rising_edge(i2c_clk);
        sda_out <= '0';
        wait until rising_edge(i2c_clk);
        scl <= '1';
        wait until rising_edge(i2c_clk);
        sda_out <= '1';
        wait until rising_edge(i2c_clk);
        wait until rising_edge(i2c_clk);
        wait until rising_edge(i2c_clk);
        wait until rising_edge(i2c_clk);

    end i2c_read_32;

    -- clocks
    signal fast_clk                  : std_logic := '0';
    signal b_clk                     : std_logic := '0';
    signal lrclk                     : std_logic;
    signal i2c_clk                   : std_logic := '0';

    -- i2s signal generator
    signal i2s_r                     : std_logic := '0';
    signal i2s_data_r                : std_logic_vector(31 downto 0) := x"00000A00";
    signal i2s_counter_r             : unsigned(4 downto 0) := (others => '0');
    signal bclkold_r                 : std_logic_vector(3 downto 0) := x"0";
    signal lrclkold_r                : std_logic := '0';
    signal sinus_r                   : std_logic_vector(23 downto 0) := (others => '0');
    signal sinus_real_r              : real := 0.0;

    -- i2c
    signal scl     : std_logic := '1';
    signal sda_in  : std_logic := '1';
    signal sda_out : std_logic;

    -- dut output conversion
    signal i2s_out         : std_logic;
    signal left_valid_out  : std_logic;
    signal right_valid_out : std_logic;
    signal data_out        : std_logic_vector(23 downto 0);
    signal result_left_r   : std_logic_vector(23 downto 0);
    signal result_right_r  : std_logic_vector(23 downto 0);

    -- debug model
    signal debug_data_r       : signed(53 downto 0) := (others => '0');
    signal debug_data_delay_r : signed(53 downto 0) := (others => '0');
    signal debug_result_r     : std_logic_vector(23 downto 0) := (others => '0');

    -- real model
    signal model_data_r       : real := 0.0;
    signal model_data_delay_r : real := 0.0;
    signal model_result_r     : std_logic_vector(23 downto 0) := (others => '0');

    -- control process
    signal read_data : std_logic_vector(31 downto 0);
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
