andreasbuerkler/audio/(commit log)

2018-10-08 Existing files added
    [fpga.brd, fpga.sch]
2018-10-28 Some bugfixes in FCS calculation und minor updates / FIFO updated / ETH mac top level file added
    [crc32_tb.vhd, eth_fcs.vhd, eth_mac.vhd, fifo.vhd, fifo_tb.vhd]
2018-11-11 ETH stuff added (only ARP response working) / testbench compile script added / Quartus project and timing constraints updated / minor bugfix in ETH MAC
    [arp_processing.vhd, audio_top.vhd, eth_mac_tb.vhd, eth_processing.vhd, eth_subsystem.vhd, fifo.vhd, rmii_interface.vhd]
2018-12-09 Some bugfixes in eth_processing / testbench of eth_subsystem renamed / testbench compile script updated
    [eth_processing.vhd, eth_subsystem_tb.vhd]
2018-12-16 eth testbench updated and some bugfixes
    [eth_ip.vhd, eth_processing.vhd, eth_subsystem_tb.vhd]
2018-12-26 ip checksum fixed /udp packet receive now functional
    [eth_ip.vhd, eth_subsystem_tb.vhd, udptransfer.cpp, udptransfer.h]
2018-12-29 registerbank added to top level file / some bugfixes
    [audio_top.vhd, eth_ctrl.vhd, eth_subsystem.vhd, eth_subsystem_tb.vhd, mainwindow.cpp, registeraccess.cpp, registerbank_tb.vhd]
2019-03-09 convolution test bench updated and fixed / pll added / convolution added to top level
    [audio_pll.vhd, audio_top.vhd, convolution.vhd, convolution_tb.vhd]
2019-10-27 PoE HW added
    [PoE.brd, PoE.sch]
2020-01-04 I2C master added
2020-01-26 design files for FPGA board added
    [fpga.brd, fpga.sch]
2020-01-29 Some bugfixes in I2C master
    [i2c_master.vhd]
2020-04-26 Timing constraints updated / global and eth phy reset added / minor fixes
    [eth_ctrl.vhd, lcd_top.vhd, registerbank.vhd]
2020-05-16 hyper ram controller testbench updated / some fixes in eth_ctrl for burst transfers
    [eth_ctrl.vhd, hyper_ram_controller_tb.vhd]
2020-05-18 files for lcd board added
    [lcd.brd, lcd.sch]
2020-05-20 master interconnect testbench added / some bugfixes in master interconnect / master interconnect added to top level file
    [lcd_top.vhd, master_interconnect.vhd, master_interconnect_tb.vhd]
2020-05-23 master interconnect testbench updated + bugfix
    [master_interconnect.vhd, master_interconnect_tb.vhd]
2020-05-30 Bugfix in master interconnect
    [master_interconnect.vhd, master_interconnect_tb.vhd]
2020-06-14 LCD controller updated/fixed and connected in top level
    [lcd_controller.vhd, lcd_controller_tb.vhd, lcd_top.vhd]
2020-08-02 lcd controller updated to support double buffer / recover when DMA is too slow
    [lcd_controller.vhd, lcd_controller_tb.vhd, lcd_top.vhd]
2020-08-03 interconnect testbench added / bugfix in slave_interconnect
    [interconnect_tb.vhd, slave_interconnect.vhd, slave_interconnect_tb.vhd]
