andreasbuerkler/audio/(notices)

Notices in the files:
parts and their libraries:
micrel_phy: Copyright (C) 2008, Bob Starr
torex: Copyright (C) 2015, Bob Starr
